pocopepe/visualizer/pll-sky130/docs/final_proposal/tab_dev.tex

\begin{tabular}{lrrrrrr}\toprule
Corner & N $I_d$ 0.9 V ($\mu$A) & P $I_d$ 0.9 V ($\mu$A) & N $I_d$ 1.8 V ($\mu$A) & P $I_d$ 1.8 V ($\mu$A) & N $V_{th}$ (V) & P $|V_{th}|$ (V) \\\midrule
ss & 27.9 & 0.112 & 401.2 & 69.9 & 0.6945 & 1.3376 \\
sf & 51.3 & 0.082 & 480.0 & 68.5 & 0.6333 & 1.3548 \\
tt & 36.9 & 0.211 & 438.2 & 86.5 & 0.6693 & 1.3229 \\
fs & 25.3 & 0.518 & 397.2 & 104.4 & 0.7054 & 1.2800 \\
ff & 47.7 & 0.403 & 475.4 & 103.2 & 0.6441 & 1.3000 \\
\bottomrule\end{tabular}
