pocopepe/visualizer/pll-sky130/docs/diagrams/vco_schematic.tex

\documentclass[border=10pt]{standalone}
\usepackage{circuitikz}
\begin{document}
\begin{circuitikz}[every node/.style={font=\small}]
% ===================== BIAS GENERATOR =====================
\node[font=\bfseries] at (0,9.3) {Bias generator};
\draw (0,7.6) node[vdd]{VDD};
\node[pmos, anchor=S] (Mpb) at (0,7.6) {};
\node[nmos, anchor=D] (Mnb) at (0,5.2) {};
\draw (Mpb.D) -- (Mnb.D);
\draw (Mnb.S) node[ground]{};
\draw (Mpb.G) -- ++(0,-0.6) coordinate(dg) -| (Mpb.D);
\coordinate (vbp) at (0,5.8);
\draw (vbp) node[circ]{};
\node[right] at (vbp) {\footnotesize vbiasp};
\draw (Mnb.G) -- ++(-0.6,0) node[left]{$V_{ctrl}$};
\node[left, xshift=-0.5cm] at (Mpb.west) {\footnotesize Mpb (diode)};
\node[right] at (Mnb.east) {\footnotesize Mnb};
% ===================== ONE RING STAGE =====================
\node[font=\bfseries, align=center] at (6,9.5) {One ring stage\\(current-starved inverter)};
\draw (6,7.6) node[vdd]{VDD};
\node[pmos, anchor=S] (Mpcs) at (6,7.6) {};
\node[pmos, anchor=S] (Mpinv) at (6,6.1) {};
\node[nmos, anchor=D] (Mninv) at (6,4.1) {};
\node[nmos, anchor=D] (Mncs) at (6,2.6) {};
\draw (Mpcs.D) -- (Mpinv.S) node[midway,circ]{} node[midway,right]{\footnotesize nodeA};
\draw (Mpinv.D) -- (Mninv.D) node[midway,circ](o){};
\draw (o) -- ++(0.9,0) node[right]{out};
\draw (Mninv.S) -- (Mncs.D) node[midway,circ]{} node[midway,right]{\footnotesize nodeB};
\draw (Mncs.S) node[ground]{};
\draw (Mpinv.G) -- ++(-0.4,0) coordinate(a) (Mninv.G) -- ++(-0.4,0) coordinate(b);
\draw (a) -- (b) node[midway,circ](in){};
\draw (in) -- ++(-0.6,0) node[left]{in};
\draw (Mpcs.G) -- ++(-2.2,0) node[left]{vbiasp};
\draw (Mncs.G) -- ++(-2.2,0) node[left]{$V_{ctrl}$};
\node[right] at (Mpcs.east) {\footnotesize Mp\_cs};
\node[right] at (Mpinv.east) {\footnotesize Mp\_inv};
\node[right] at (Mninv.east) {\footnotesize Mn\_inv};
\node[right] at (Mncs.east) {\footnotesize Mn\_cs};
\node[align=left, font=\footnotesize, text width=6cm] at (1.8,0.9) {gates of Mp\_cs/Mn\_cs are the SAME nets as the bias generator (vbiasp / $V_{ctrl}$)};
\end{circuitikz}
\end{document}
