pocopepe/visualizer/pll-sky130/docs/diagrams/method_flow.tex

\documentclass[tikz,border=10pt]{standalone}
\usetikzlibrary{arrows.meta,positioning}
\begin{document}
\begin{tikzpicture}[
  >=Stealth, thick, font=\sffamily\small, node distance=0.55cm and 0.55cm,
  st/.style={draw, rounded corners=3pt, minimum height=1.35cm, text width=2.55cm, align=center, fill=white},
  r1/.style={st, fill=gray!10},
  r2/.style={st, fill=blue!8, draw=blue!60!black},
  chk/.style={st, fill=green!8, draw=green!45!black},
  lab/.style={font=\sffamily\scriptsize, align=center}
]
\node[r1] (a) {Hand-written\\SPICE netlists\\(sky130, ngspice)};
\node[r1, right=of a] (b) {Each block\\verified\\standalone};
\node[r1, right=of b] (c) {Averaged loop\\model: 573 ns\\(sim: 577)};
\node[r1, right=of c] (d) {Closed loop\\locks: 577 ns\\(Review 1)};

\node[r2, below=1.2cm of a] (e) {11-corner grid\\(3$\times$3 + PDK skew)\\$\times$ 6 temperatures};
\node[r2, right=of e] (f) {Fit $f(T)$,\\derive $k_1,k_2$\\per corner};
\node[chk, right=of f] (g) {Held-out\\temperatures\\(never fitted)};
\node[chk, right=of g] (h) {Monte Carlo\\mismatch, n = 72\\paired by seed};

\node[r2, below=1.2cm of e] (i) {Cold-start boost;\\loop audit, R2\\retune ($\zeta$ 0.7)};
\node[chk, right=of i] (j) {Paired t-test +\\Wilcoxon on\\$|$drift$|$};
\node[r2, right=of j] (k) {Compare to\\$\pm0.3\%$ spec\\and literature};
\node[st, right=of k, fill=yellow!12] (l) {Review 3:\\transistor-level,\\layout, Spectre};

\draw[->] (a)--(b); \draw[->] (b)--(c); \draw[->] (c)--(d);
\draw[->] (d.south) -- ++(0,-0.35) -| (e.north);
\draw[->] (e)--(f); \draw[->] (f)--(g); \draw[->] (g)--(h);
\draw[->] (h.south) -- ++(0,-0.35) -| (i.north);
\draw[->] (i)--(j); \draw[->] (j)--(k); \draw[->] (k)--(l);

\node[lab, above=0.1cm of a, xshift=4.6cm] {\textbf{Review 1} --- build and close the loop};
\node[lab, above=0.1cm of e, xshift=4.6cm] {\textbf{Review 2} --- characterise, compensate, validate};
\node[lab, below=0.25cm of j, xshift=1.6cm, text width=12cm] {grey = Review 1\quad blue = design step\quad green = validation step (guards against fooling ourselves)};
\end{tikzpicture}
\end{document}
