pocopepe/visualizer/Final_Proposal_and_Findings.pdf

VIT Chennai – School of Electronics Engineering (SENSE)

## Design of a Temperature-Compensated PLL Frequency Synthesiser

Final Proposal and Findings Report

Aaryan Dogra Yugeshwaran | Viju Sanjai
23BEC1032 | 23BEC1404 | 23BEC1306
Guide: Dr. B. Bindu | Final review (Review-III): 28.10.2026
Document date: 28.10.2026

Abstract

A ring-oscillator VCO drifts strongly with temperature, which moves the control voltage, lock range, KVCO and lock time of a PLL built around it. We built a complete integer-N charge-pump PLL (226.2 MHz output, ÷8, 28.275 MHz reference) in the open SkyWater sky130B process and simulated it in ngspice. The VCO drift (uncompensated span 8.51 % at the typical corner) was characterised on 11 process corners, and an ideal behavioural first- and second-order correction was fitted and verified on all of them. It brings the nominal drift to within ±0.3 % at 8 of 11 corners (typical corner: 0.16 %); it misses at three slow-NMOS corners. Under transistor mismatch (Monte Carlo, n = 72) the compensated drift is limited to about 1.2–1.4 % by a mismatch floor, and the second-order term gives no statistically detectable benefit over the first. The closed loop locks to 8 × fref in every one of 28 simulated cases; the slowest case (ss, 85 ◦C, cold start, 2083 ns) misses the 2 µs specification by 4 %. Nine earlier errors, found and corrected during the work, are listed. Not yet done: the compensation network and charge pump are still behavioural, there is no layout, no jitter or phase-noise figure, and the cross-simulator (Cadence) test is blocked on tool access. Section 8 proposes a scoped plan with acceptance criteria and states what we need from the guide.

### 1 Introduction and problem

A phase-locked loop (PLL) frequency synthesiser multiplies a stable reference to a higher output frequency. Ring-oscillator VCOs are attractive for integrated PLLs because they are small and need no inductor, but their frequency changes strongly with temperature. In a PLL locked to an external reference the output is fout = N fref exactly, so the temperature coefficient of the locked output frequency is that of the reference and is not something the VCO design can change. The original project target of ±0.15 ppm stability therefore measures the reference crystal, not our circuit, and we propose to restate it (Section 8.3).
What temperature does degrade in a locked PLL is the following.
- Control voltage. The Vctrl needed for the target frequency moves with temperature and process. If it approaches a rail the loop loses lock range or lock.
- Lock range. Derived from the usable Vctrl window; the VCO is below 18 MHz for Vctrl < 0.65 V, so the practical floor is ≈ 0.65 V.
- KVCO. It sets loop bandwidth ωn ∝

√
KVCO and damping ζ ∝

√
KVCO at fixed filter, so
stability and settling move with process and temperature.
- Lock time. The time to acquire depends on the start state, KVCO and the distance to the lock voltage.

The aim of the project is therefore to reduce the free-running VCO drift with a compensation network and to show, in a complete closed loop, what that buys. The work is simulation-only in an open flow (Xschem/ngspice, Magic, netgen); it is staged as Review 1 (blocks and open-loop VCO), Review 2 (corners, compensation, Monte Carlo, first closed loop) and the present Final Review.

Contributions of this report. (i) A corner-aware characterisation of a current-starved ring VCO on 11 corners including a textbook 3 × 3 NMOS×PMOS set built from the PDK’s own model files; (ii) an ideal behavioural second-order compensation fitted on the measured f(T, V ) surface and verified at held-out temperatures; (iii) a paired Monte Carlo (n = 72) that identifies a mismatch floor; (iv) a 28-case closed-loop campaign; (v) an explicit list of nine corrections we made to our own earlier claims; (vi) a scoped plan for the remaining work.

### 2 Related work, novelty and research gap

Temperature-compensated ring oscillators and PLLs. Souliotis et al. report a fabricated PTAT-compensated ring-oscillator VCO in 180 nm CMOS with −1.5 %/+ 0.4 % frequency variation over −40 to 120 ◦C [1]; it is the closest published silicon and our main quantitative reference. Stancu et al. describe a temperature- and supply-compensated ring-oscillator clock circuit with 1.6 % temperature error in pre-layout simulation at 50 MHz [2]. Geng et al. present a fast-locking PLL synthesiser with temperature compensation (lock time below 2 µs, 9 mW) [3]. Further work on compensated or PVT-tolerant ring oscillators and ring VCOs is in [9, 10, 11, 13, 14, 15]; compensation of an LC-VCO inside a 12 GHz PLL is in [4]. General CMOS PLL synthesiser design references are [5, 8]. We read these as prior art for “a PTAT-type compensated ring VCO” and do not claim that idea.

Open-source analog flows. Freitas et al. compare open-source and commercial EDA for three blocks in IHP SG13G2, one of them a current-starved ring VCO, but their analog comparison is qualitative and open-loop [6]. Thiriloganathan et al. built a fully open-source 2.4 GHz fractional-N LC-VCO PLL in IHP SG13G2 and note the absence of PSS/Pnoise in open tools [7]. Open sky130 PLL projects exist as well (informal repositories, not cited as references).

Patent that narrows our novelty. US Patent 9,748,962 B2 (Infineon, 2017) combines a linear PTAT term with a squared term through a translinear squarer for oscillator temperature compensation over −40 to 85 ◦C [12]. The general idea “add a quadratic term to a linear compensator” is therefore not novel and we do not claim it. The patent is generic (it positions itself as an alternative to PLL-based stabilisation), not ring-VCO-specific, and none of the ring-oscillator papers above that we read goes beyond first order.

What is not novel. PTAT-compensated ring VCOs; quadratic compensation; PLLs built with open tools; open-vs-commercial EDA comparisons for digital blocks.

Gap and honest claim. What we did not find in the sources above is a closed-loop, per-corner, statistically validated study of curvature compensation of a ring VCO inside a PLL on an open PDK. That composite is our claim; each ingredient on its own is not. Our second planned claim, the cross-simulator hypothesis H1 (Section 8.7), is untested. This section is a literature check against the 15 references listed, not an exhaustive survey.

### 3 Design: architecture and block-level implementation

The loop is an integer-N charge-pump PLL (Fig. 1). Technology sky130B (volare commit c6d73a35); supply 1.8 V; simulator ngspice 47 (it reproduces the earlier ngspice-42 numbers exactly); all circuits are hand-written SPICE netlists run headless. Target output 226.2 MHz at Vctrl = 0.9 V (tt, 27 ◦C), fref = 28.275 MHz, N = 8.


Figure 1: PLL block diagram. PFD, divider and VCO are transistor-level; the charge pump is behavioural.

PFD. Edge detectors feeding a cross-coupled NOR SR latch (instead of resettable D flip-flops, to avoid fighting the latch feedback with an asynchronous reset). Functionally verified by sweeping the phase relationship.

Charge pump (behavioural). Icp = 20 µA, an ideal current source gated by UP/DN: no switch resistance, no mismatch, no charge injection. A 5× boost of the pump current is applied until the first divider edge, so that a true 0 V start can recover (Fig. 2).

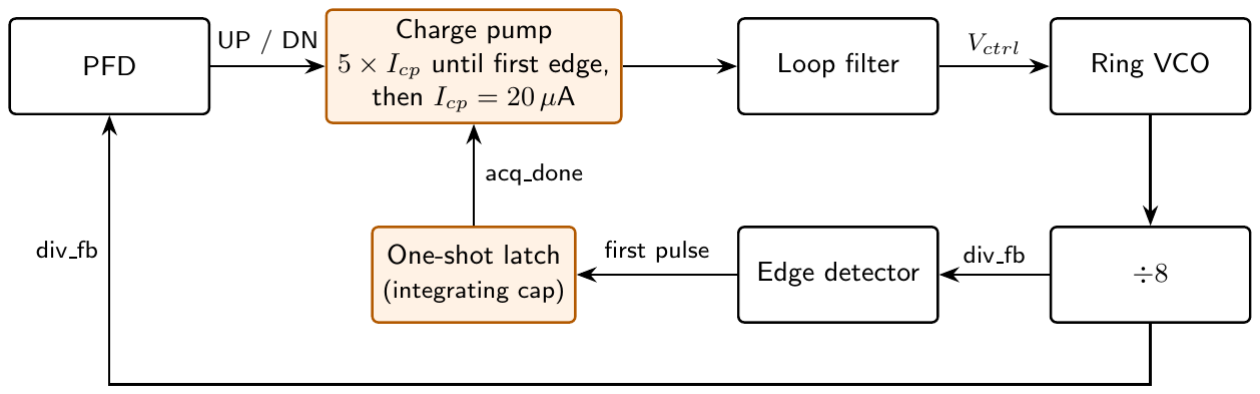
[picture p20: figure]

Figure 2: Acquisition aid: pump current boosted 5× until the first divider edge.

Loop filter. R2 = 3.6 kΩ in series with C1 = 68 pF, C2 = 6.8 pF in parallel. The original R2 = 1.7 kΩ is superseded (Section 6.3).

VCO. A 5-stage current-starved ring (Fig. 3). Vctrl drives the NMOS current-source gates directly and, through a V-to-I device and a PMOS mirror, the PMOS current sources, so it sets the delay per stage. Default sizing: switching devices W/L = 1.0/0.5 (N) and 2.0/0.5 (P), current sources 2.0/0.5 µm (all sky130 nfet_01v8/pfet_01v8); supply current about 58 µA at the 0.9 V bias point. The tuning curve is S-shaped: 18 MHz at 0.65 V to 358 MHz at 1.40 V (tt), 226.2 MHz at 0.9 V, with a local KVCO ≈ 890 MHz/V at 0.9 V (tt). There is no hard oscillation floor: 0.63, 2.1, 6.5 and 18 MHz at 0.50, 0.55, 0.60 and 0.65 V.

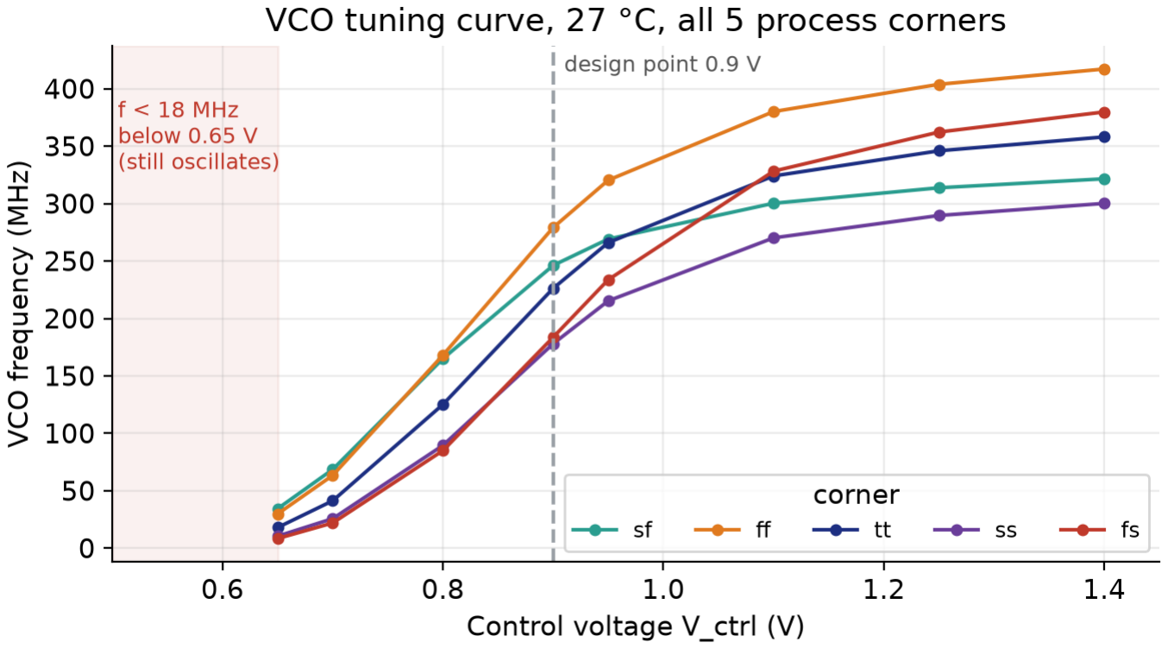
[picture p21: figure]

Figure 3: Left: current-starved ring VCO. Right: tuning curve at tt, 27 ◦C.

Divider. ÷8 from three cascaded toggle flip-flops; measured ratio 8.004 in the block test.

Compensation network (behavioural). In the simulations the correction is an ideal voltage source in series with Vctrl:

V

eff
ctrl = Vctrl + k1(T − 27) + k2(T − 27)²
. | (1)

k2 = 0 gives a first-order (PTAT/CTAT-equivalent) network. A transistor-level realisation (PTAT/CTAT plus translinear squarer) is proposed in Section 8 (Fig. 4).

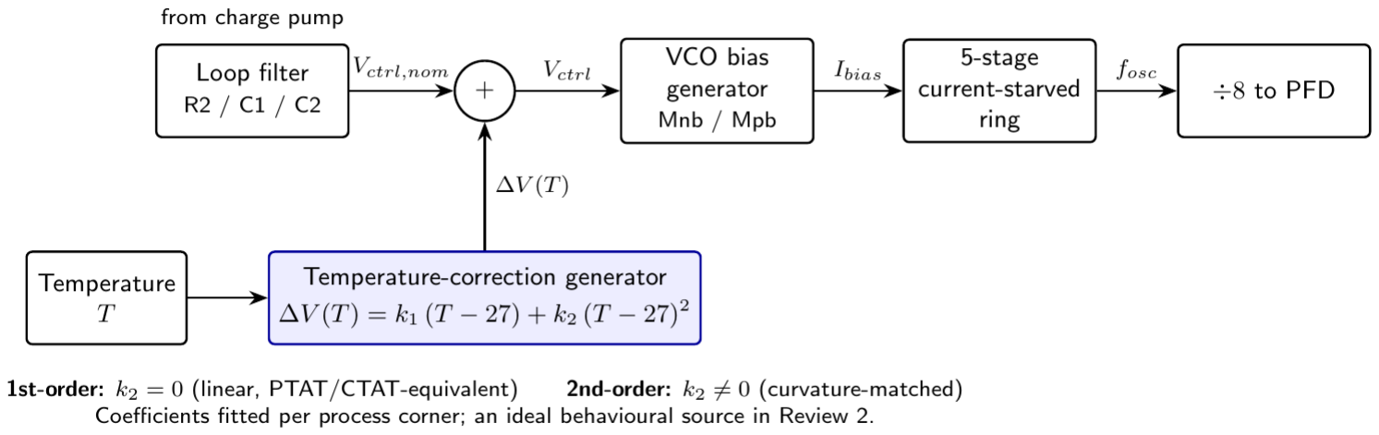
[picture p22: figure]

Figure 4: Compensation architecture (target realisation; the present simulations use the ideal source of Eq. 1).

### 4 Methodology

### 4.1 Simulation flow

Every result is produced by headless ngspice batch runs driven by Python scripts, from netlists under blocks/. Raw outputs and per-run JSON are kept under results/; every headline number is regenerated into results/final_numbers.md by a script, and the tables in this report are generated from that file. Appendix A lists the commands.

### 4.2 Corner methodology

sky130 ships the corners ss, tt, ff and two skew corners sf, fs. During the final preparation we found that the VCO results did not look like textbook corners and audited them. We measured the devices directly (Table 1) and found: (a) in this PDK sf is fast-NMOS/slow-PMOS and fs is slow-NMOS/fast-PMOS (measured; our earlier labels were reversed; the PDK documentation does not state it unambiguously); (b) the skew corners shift each device further than ss/ff do: extracted NMOS Vth vs tt is +25 (ss), −25 (ff), −36 (sf), +36 mV (fs), PMOS |Vth| +15, −23, +32, −43 mV. At the VCO bias (overdrive ≈ 0.2 V) this becomes ≈ 9 % in drive current, so the PDK skews lie outside the ss–ff envelope at 0.9 V but inside it at 1.8 V (NMOS Id within 1 %).

Corner | N Id 0.9 V (µA) | P Id 0.9 V (µA) | N Id 1.8 V (µA) | P Id 1.8 V (µA) | N Vth (V) | P |Vth| (V)
ss | 27.9 | 0.112 | 401.2 | 69.9 | 0.6945 | 1.3376
sf | 51.3 | 0.082 | 480.0 | 68.5 | 0.6333 | 1.3548
tt | 36.9 | 0.211 | 438.2 | 86.5 | 0.6693 | 1.3229
fs | 25.3 | 0.518 | 397.2 | 104.4 | 0.7054 | 1.2800
ff | 47.7 | 0.403 | 475.4 | 103.2 | 0.6441 | 1.3000

Table 1: Single-device audit at 27 ◦C (W/L = 2/0.5 µm, ngspice 47). Skew corners fall outside the ss–ff band for the NMOS at 0.9 V (25.3 and 51.3 vs 27.9 and 47.7 µA). PMOS at 0.9 V is sub-threshold.

We therefore report on 11 corners: a textbook 3 × 3 set (NMOS slow/typ/fast × PMOS slow/typ/fast), named nXpY (nsps=ss, ntpt=tt, nfpf=ff exactly as in the PDK), built by swapping the NMOS and PMOS model files independently (scripts/make_factorial_lib.py; the diagonal reproduces the PDK ss/tt/ff to the digit: 177.993/226.206/279.178 MHz), plus the PDK’s own skews as wider “foundry” extremes. We always label by device behaviour, never by the letters alone.

### 4.3 Compensation fit

The first analytic coefficients (Review 2) were derived from a wrong KVCO and a first-order guess; they are superseded (Section 6.3). The method now used (scripts/comp_factorial.py), per corner:
1. measure f(T, V ) at V ∈ {0.85, 0.90, 0.95} V and T ∈ {−40, −20, 0, 27, 50, 85}

◦C (no correction);
2. solve for the exact shift ∆V
| | ∗
(T) that restores f(27 ◦C) (quadratic interpolation in V );
3. least-squares fit ∆V

∗ = k1∆T (first order) and k1∆T + k2∆T
| | | | 2
(second order), ∆T = T − 27;
4. verify by simulating the compensated VCO at the six fit temperatures and at four held-out temperatures (−30, 10, 40, 70 ◦C).

Reported metrics: span = (fmax − fmin)/f27 and maximum deviation from f27 (the quantity that the ±0.3 % specification refers to), both at Vctrl = 0.9 V. The compensation ratio is C = baseline span / second-order span.

### 4.4 Monte Carlo and paired statistics

Device mismatch is enabled through the PDK’s mismatch switch with a fixed random seed set first in each run. Each seed is one simulated chip, run through all three arms (uncompensated, first order, second order) at −40 and 85 ◦C with the tt coefficients; the drift is |f(85) − f(−40)|. Arms are paired by seed; we use a paired t test with a 95 % CI and a Wilcoxon signed-rank test, and the metric is |drift| because over- and under-correction are equally bad (our first analysis tested the signed drift and was wrong; Section 6.3). n = 72 chips. Statistics are hand-written (scripts/stats.py) and self-checked.

### 4.5 Closed-loop campaign

scripts/closed_loop_campaign.py runs the full transistor-level loop (behavioural charge pump) at all 11 corners from two start states: a coarse start (Vctrl = 0.85 V) and a true cold start (Vctrl = 0 V, boosted pump); plus cold starts at −40 and 85 ◦C for ss, tt, ff. Each run is 5 µs. Lock time is the time after which Vctrl stays within ±2 % of its final value (specification < 2 µs). In total 28 simulations.

### 5 Results

### 5.1 Corner audit and VCO characterisation

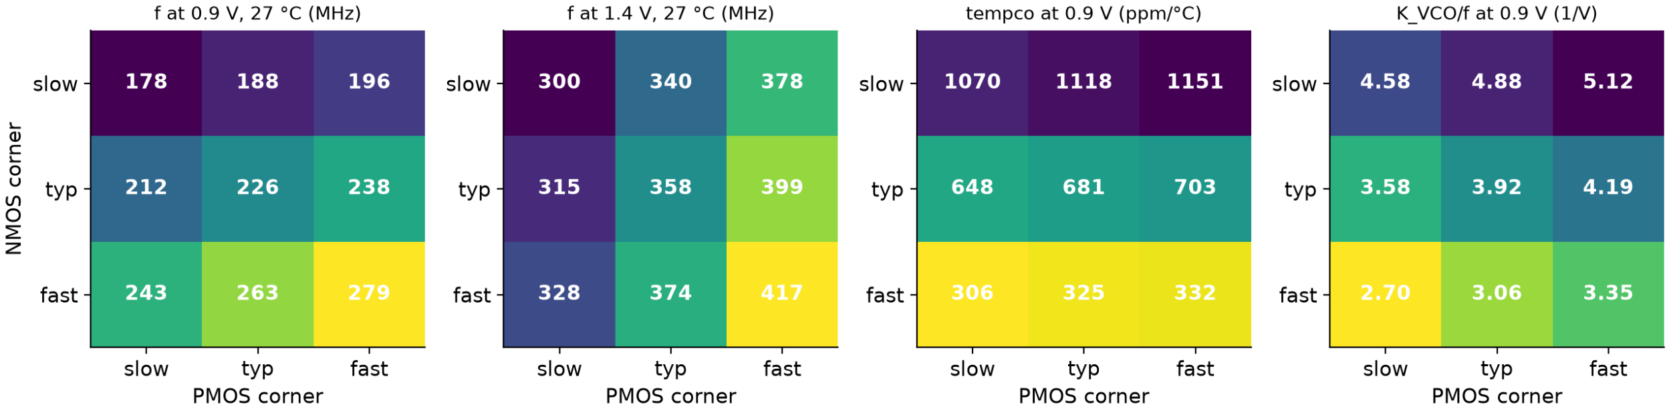
[picture p23: figure]

Figure 5: Textbook 3 × 3 NMOS×PMOS set. From left: f at 0.9 V, f at 1.4 V (27 ◦C), tempco at 0.9 V (ppm/ ◦C), KVCO/f (1/V).

At 0.9 V and 27 ◦C the frequency is 178.0/188.0/195.9 (N slow), 211.8/226.2/238.1 (N typ), 242.8/262.7/279.2 MHz (N fast) for P slow/typ/fast. Tempco is 1070/1118/1151, 648/681/703 and 306/325/332 ppm/ ◦C; the textbook range is 306–1151 (3.8×) and the PDK five-corner range is 112 (sf)–1399 (fs) ppm/ ◦C (12.5×), with ss 1070, tt 681 and ff 332. All 8 monotonicity checks pass (frequency rises with NMOS and with PMOS strength at 0.9 and 1.4 V; tempco falls with NMOS strength). The only failed expectation is that the PDK skews’ tempco lies inside [ff, ss]; it does not, even in a clean textbook set tempco is not bounded by ff and ss. Physics checks pass: Vth tempco −0.78 mV/ ◦C (N) and −1.1 mV/ ◦C (P); NMOS Id at 1.8 V falls with temperature (−30 %) while at 0.9 V it rises (+14 %), i.e. the bias sits below the zero-tempco point; at Vctrl = 1.4 V the tempco is −816 ppm/ ◦C (sign flip). At 0.9 V the NMOS limits the ring (36 % spread slow-to-fast N vs 10 % across P); at 1.4 V the PMOS does (26 % vs 9 %). Uncompensated at tt the span is 8.51 %. Local KVCO at 0.9 V (MHz/V): sf 580, ff 940, tt 890, ss 820, fs 1020 (the earlier 669 was wrong).


Figure 6: Left: uncompensated VCO drift vs temperature (tt). Right: tempco ranks with NMOS drive.

### 5.2 Compensation on 11 corners

Corner | f0 (MHz) Base span (%) 2nd span (%) Max dev (%) Held-out (%) | C ±0.3 %
nsps (ss) | 178.0 | 13.37 | 0.35 | 0.277 | 0.175 38.4 yes
nspt | 188.0 | 13.97 | 0.38 | 0.301 | 0.201 37.2 NO
nspf | 195.9 | 14.38 | 0.42 | 0.325 | 0.223 34.3 NO
ntps | 211.8 | 8.10 | 0.24 | 0.195 | 0.109 33.6 yes
ntpt (tt) | 226.2 | 8.51 | 0.20 | 0.162 | 0.091 43.2 yes
ntpf | 238.1 | 8.79 | 0.20 | 0.168 | 0.097 43.7 yes
nfps | 242.8 | 3.82 | 0.12 | 0.079 | 0.034 31.0 yes
nfpt | 262.7 | 4.06 | 0.12 | 0.102 | 0.041 33.3 yes
nfpf (ff) | 279.2 | 4.15 | 0.11 | 0.093 | 0.035 37.0 yes
PDK sf (N fast, P slow) | 246.2 | 1.49 | 0.09 | 0.051 | 0.036 15.9 yes
PDK fs (N slow, P fast) | 183.7 | 17.49 | 0.49 | 0.360 | 0.251 35.8 NO

Table 2: Compensation, nominal (no mismatch), ideal behavioural source, Vctrl = 0.9 V. “Max dev” is the maximum deviation from f27 of the second-order-compensated VCO at the 6 fit temperatures; “Held-out” the same at −30, 10, 40, 70 ◦C.

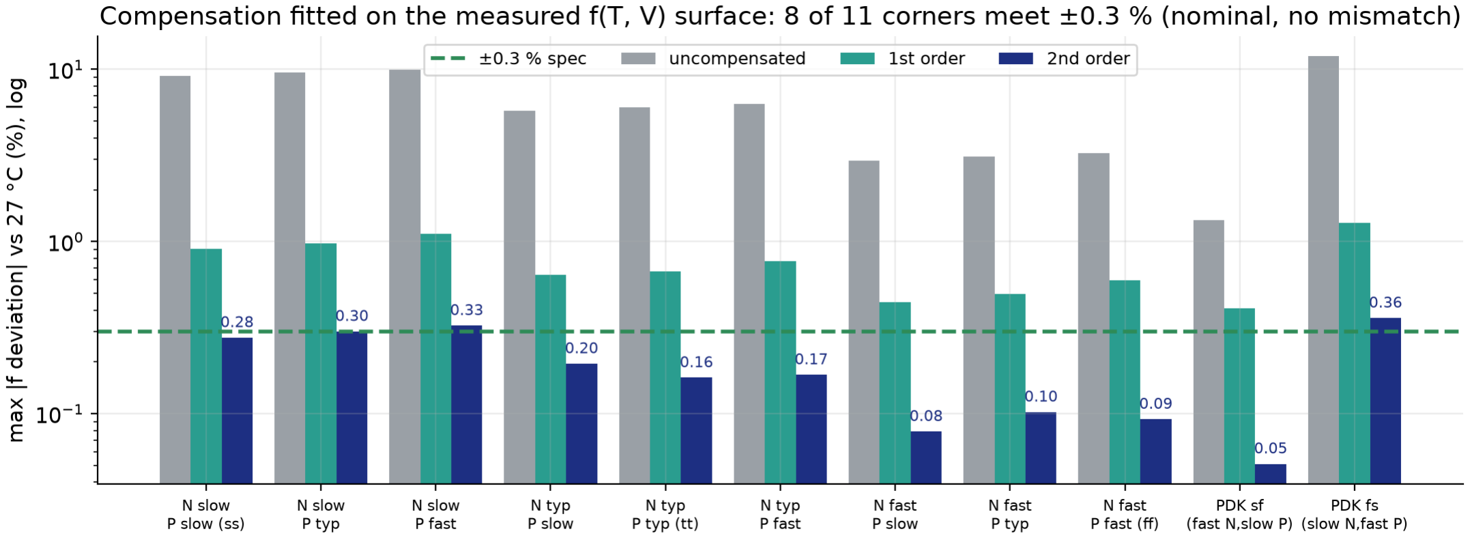
[picture p24: figure]

Figure 7: Maximum deviation from f27 (log scale) for the uncompensated, first-order and second-order cases at 11 corners.

At tt the span falls from 8.51 % to 0.67 % (first order) and 0.20 % (second order), maximum deviation 0.16 % (specification ±0.3 % met), held-out 0.09 %, with k1 = −1.543 × 10⁻⁴ V/ ◦C and k2 = 4.18 × 10⁻⁷ V/ ◦C
2
. 8 of 11 corners meet ±0.3 % (7 of the 9 textbook corners). The misses are nspt 0.301 % (borderline), nspf 0.325 % and PDK fs 0.360 %; all are slow-NMOS corners, the hardest. C lies between 31 and 44 for ten corners and is 15.9 for PDK sf (small baseline drift). Held-out maxima are 0.03–0.25 %, so the two fitted coefficients do not over-fit the five non-reference fit temperatures. Per-corner coefficients are in Appendix B.

Caveats on this result
The correction is an ideal source (no transistor-level network, no noise, no supply dependence); it is nominal (no mismatch); two coefficients are fitted to five temperature points; and the fit is made at Vctrl = 0.9 V while each corner locks at its own Vctrl (Section 5.4).

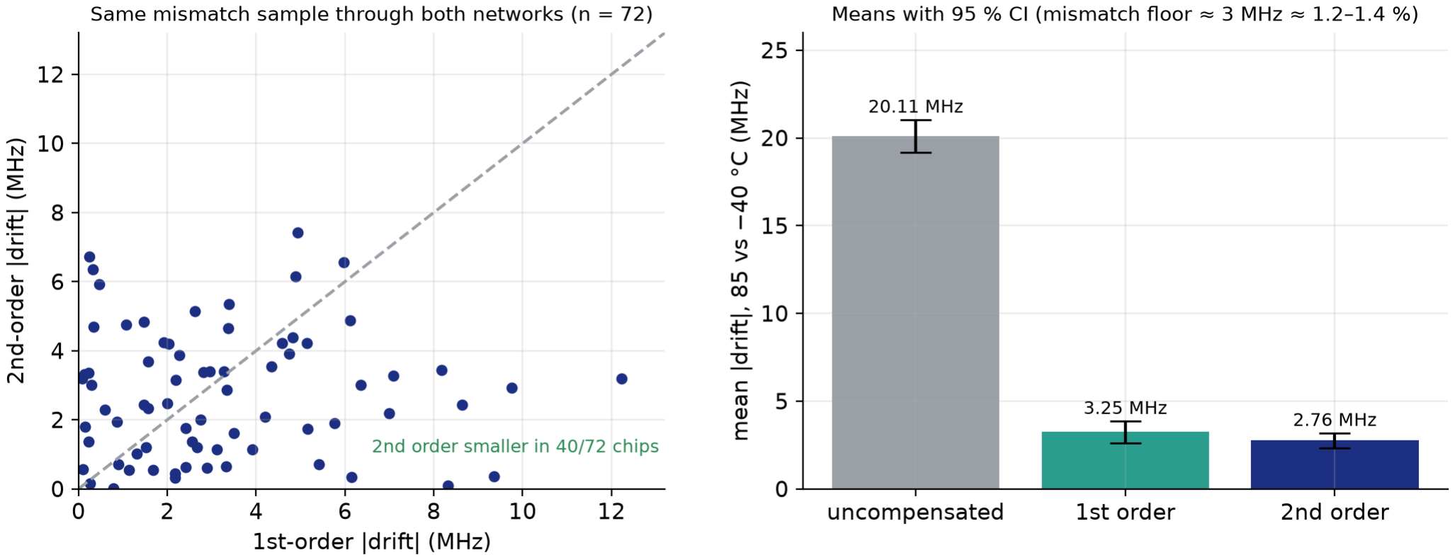
[picture p25: figure]

Figure 8: Monte Carlo at tt with mismatch (n = 72 chips, paired by seed). Left: second- vs first-order |drift| per chip. Right: means with 95 % CI.

Arm | mean |drift| (MHz) | 95 % CI (MHz) | as % of 226.2 MHz
Uncompensated | 20.11 | [19.18, 21.04] | –
First order | 3.25 | [2.63, 3.87] | 1.4
Second order | 2.76 | [2.33, 3.19] | 1.2
Paired comparison | reduction (MHz), CI | wins
Base → 1st | 16.86 [15.57, 18.16] | 71/72
Base → 2nd | 17.35 [16.37, 18.34] | 72/72
1st → 2nd | 0.49 [−0.26, 1.24], n.s. | 40/72

Table 3: Monte Carlo statistics. Both t and Wilcoxon tests agree: both compensations significantly reduce drift; 1st → 2nd is not significant.

### 5.3 Monte Carlo, n = 72, and the mismatch floor

Either compensation removes 84–86 % of the drift under mismatch, in nearly every chip. But the residual of about 3 MHz (1.2–1.4 % of 226 MHz) is several times the nominal residual (0.2–0.7 %): it is a mismatch floor. Chip-to-chip mismatch makes every chip’s own drift differ (signed drift std 4.1 MHz first order, 3.3 MHz second order), and one global correction cannot remove a per-chip error. With correctly fitted coefficients the second-order term gives no statistically detectable benefit under mismatch. Reaching ±0.3 % across chips would require per-chip trim (Section 8.4). Monte Carlo was run at the tt corner only.

### 5.4 Closed loop

Retune. The Review-1 filter design had dropped the 1/(2π) of the PFD/charge-pump gain, so ζ was 0.33, not 0.72. Retuning R2 from 1.7 to 3.6 kΩ gives ζ ≈ 0.70 (phase margin ≈65–70◦ by the 100ζ rule, not a Bode plot). At tt: coarse-start lock 577 →503 ns, cold start 839 → 1351 ns (slower but within specification), ripple 8.6 → 0.35 mV, final frequency error 0.78 % → 0.008 %. The original loop had not settled within 2 µs at ff, sf, fs, ss. Only R2 = 1.7, 3.0 and 3.6 kΩ were simulated at transistor level; 3.6 kΩ is not claimed optimal.

Lock at all corners. In all 28 runs fVCO = 226.17 MHz (−0.01 %, the bias of the crossing detector) = 8fref , ripple ≤ 0.8 mV, all settled. Lock times at 27 ◦C are in Table 4 and Fig. 9; all are below 2 µs.

Corner | Vlock (V) | Coarse start (ns) | Cold start (ns)
nsps (ss) | 0.968 | 967 | 1675
nspt | 0.944 | 645 | 1531
nspf | 0.930 | 573 | 1354
ntps | 0.920 | 678 | 1537
ntpt (tt) | 0.900 | 503 | 1351
ntpf | 0.888 | 177 | 1318
nfps | 0.877 | 387 | 1391
nfpt | 0.860 | 279 | 1316
nfpf (ff) | 0.849 | 241 | 1282
PDK sf (N fast, P slow) | 0.869 | 419 | 1388
PDK fs (N slow, P fast) | 0.942 | 576 | 1355
Corner | −40 ◦C | 27 ◦C | 85 ◦C
ss | 1633 | 1675 | 2083
tt | 1318 | 1351 | 1418
ff | 1248 | 1282 | 1317

Table 4: Top: lock voltage and lock time at 27 ◦C by corner. Bottom: cold-start lock time (ns) vs temperature. The ss/85 ◦C case misses the 2 µs specification by 4 % (2083 ns).

Validation checks. (i) The closed-loop lock Vctrl equals the open-loop Vctrl for 226.2 MHz within 0.2 mV at all 11 corners (Fig. 11). (ii) At tt the lock voltage moves +11.9 mV at −40 ◦C and −7.5 mV at 85 ◦C, matching the fitted compensation correction at tt (+12.2/−7.5 mV): an independent confirmation of the compensation fit at tt. At other corners the comparison is not valid because the compensation is fitted at 0.9 V whereas each corner locks at its own Vctrl (ss 0.968, nspt 0.944, nspf 0.930, ntps 0.920, tt 0.900, ntpf 0.888, nfps 0.877, nfpt 0.860, ff 0.849, PDK sf 0.869, PDK fs 0.942 V). This motivates defining the compensation target at each corner’s own lock voltage

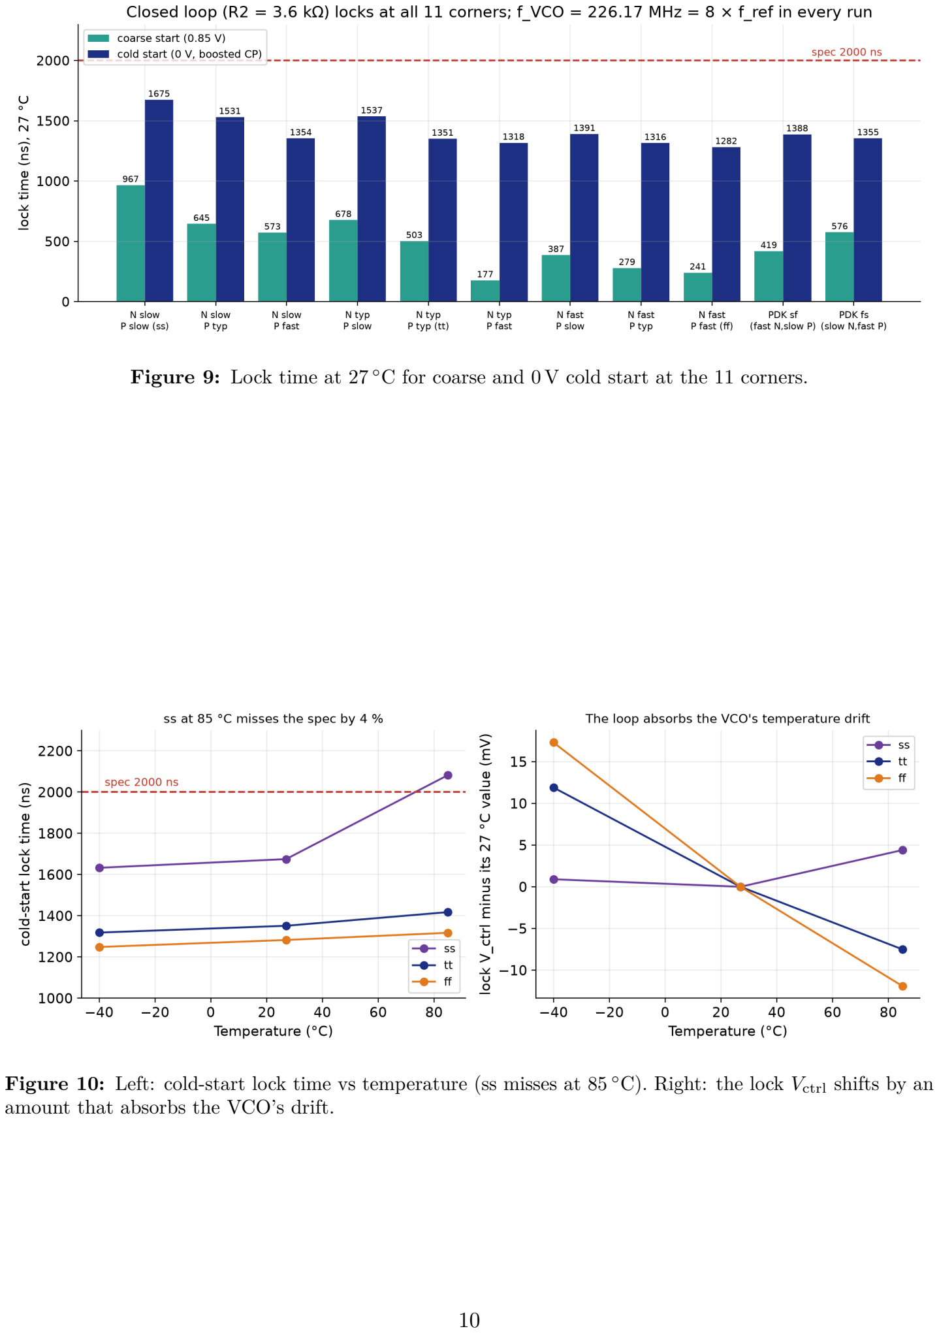
[picture p26: page 10]

Figure 9: Lock time at 27 ◦C for coarse and 0 V cold start at the 11 corners.

Figure 10: Left: cold-start lock time vs temperature (ss misses at 85 ◦C). Right: the lock Vctrl shifts by an amount that absorbs the VCO’s drift.

(Section 8.5). (iii) An earlier averaged behavioural model of the loop reproduced the original 577 ns lock to within 1 % (573 ns).


Figure 11: Left: closed-loop vs open-loop lock Vctrl at 11 corners. Right: 0 V cold start at ss, tt, ff.

### 6 Discussion

### 6.1 What the numbers mean

The locked output frequency does not drift; what the PLL does is move Vctrl to absorb the VCO’s drift, and compensation reduces how far Vctrl has to move. Process, not temperature, dominates the lock voltage: across corners Vctrl at lock spans 0.849–0.968 V (119 mV), while temperature moves it by about 20 mV at tt. All lock voltages stay well above the 0.63 V practical floor, so lock range was not the limit in any simulated case. The loop closes in every case, and its dynamics move with process because KVCO varies from 580 to 1020 MHz/V. The weak spot is a slow-NMOS, hot cold start (ss, 85 ◦C).

### 6.2 Comparison with the literature (honest)

The only cleanly comparable metric is residual frequency variation over temperature. Souliotis et al. measured −1.5 %/ + 0.4 % (about 1.9 % total) over a wider range, −40 to 120 ◦C [1]; Stancu et al. report 1.6 % in simulation [2]. Our uncompensated tt span of 8.51 % is worse than both, as expected. Our compensated nominal span (0.20 % at tt) is far below them, but this is a simulation of an ideal network, with no mismatch, noise or supply dependence, against measured silicon [1]: it must not be read as beating published silicon. The number that is comparable in spirit is the mismatch-limited 1.2–1.4 %, which is in the range of [1, 2], still from simulation of an ideal network. Lock time (< 2 µs; 503 ns coarse, 1351 ns cold at tt) meets the figure quoted by [3], which is measured silicon at a much higher output frequency. We have no phase-noise number for comparison. The benchmark table is in docs/benchmark_table.md (it needs updating to the final numbers).

### 6.3 Corrections we made, and what they teach

1. sf/fs labels were reversed. Lesson: measure what a model name means; do not assume it.
2. Tempco mechanism rewritten: it follows NMOS overdrive, not N/P current-source balance.

3. KVCO 669 → ≈ 890 MHz/V. The 669 came from a fit over the whole S-shaped curve; the local slope at the operating point is what matters.
4. No hard 0.63 V oscillation floor. It was an artefact of a short simulation window.
5. Loop design dropped 1/(2π): ζ was 0.33 not 0.72; retuned to 0.70. Independent re-derivation caught it.
6. Compensation coefficients were mis-estimated through the wrong KVCO and a first-order guess; the new fit meets the specification at tt (0.16 %) and 8 of 11 corners. The Review-2 tt values (1.12 % span, 0.87 % max deviation, specification missed) are superseded.
7. Monte Carlo repeated with correct coefficients: the Review-2 claim “second order significantly better than first (23/30 seeds)” compared against a mis-tuned first-order arm and is withdrawn; at n = 72 it is not significant. (An earlier error, testing signed instead of absolute drift, had also been corrected.)
8. PDK skew corners are wider than ss/ff, not inside the envelope; the textbook 3 × 3 set was added.
9. The closed-loop campaign found that ss/85 ◦C cold start misses 2 µs by 4 %. Lesson: test the worst corner and temperature together, not separately.
Common thread: derived quantities (analytic coefficients, damping, expected corner order) were wrong more often than simulated ones, and each was caught by an independent numerical check. The plan in Section 8 keeps that practice.

### 6.4 Threats to validity

- Ideal blocks. Compensation and charge pump are behavioural; transistor-level versions may change every number in Sections 5.2–5.4.
- Single simulator, single model set. ngspice with the legacy per-corner PDK models. The PDK also ships “continuous” parameter files with different skew deltas (NMOS Vth ±15 mV for ss/ff vs ±27 mV for sf/fs); the qualitative story is the same, but the numbers would differ. This is exactly what the planned Spectre arm tests.
- Nominal fit, Monte Carlo at one corner. Mismatch was not run at other corners; the fit is at Vctrl = 0.9 V only.
- Few temperature points. Two coefficients fitted to five points, mitigated by the held-out check.
- Lock metric. The ±2 % band is sensitive at its edge (the 503 ns tt result is set by a small overshoot just outside the band); damping uses the 100ζ rule, not a Bode plot.
- Temperature coverage of closed loop. Cold start at ± temperature was simulated at three corners only; not all 11 corners at all temperatures.
- Corner definitions. SkyWater’s published documentation of the corner columns is internally inconsistent; we rely on our own measurements.

### 7 Research findings summary

1. Locked output frequency is 8fref to within −0.01 % in all 28 simulated cases; temperature acts through Vctrl, KVCO and lock time, not the output frequency.
2. The uncompensated VCO tempco spans 12.5× across the PDK corners (112–1399 ppm/ ◦C) and 3.8× in a textbook 3 × 3 set (306–1151 ppm/ ◦C); tt span is 8.51 %.
3. sky130’s skew corners are wider than ss/ff (NMOS Vth ±36 vs ±25 mV) and fall outside the ss–ff envelope by 8–9 % in drive at the 0.9 V bias, but within 1 % at 1.8 V.
4. Tempco ranks with NMOS drive at 0.9 V (NMOS overdrive dominates) and the limiting device flips to the PMOS at 1.4 V; at Vctrl = 1.4 V the tempco changes sign (−816 ppm/ ◦C).
5. An ideal second-order correction fitted on measured f(T, V ) reduces the nominal tt span from 8.51 % to 0.20 % (max deviation 0.16 %, held-out 0.09 %).

6. The ±0.3 % specification is met nominally at 8 of 11 corners and missed at nspt (0.301 %), nspf (0.325 %) and PDK fs (0.360 %).
7. Compensation ratios are 31–44 at ten corners (15.9 at PDK sf).
8. Under mismatch (n = 72, tt), mean |drift| falls from 20.11 MHz to 3.25 MHz (first order) and 2.76 MHz (second order), in 71/72 and 72/72 chips.
9. The residual is a mismatch floor of about 1.2–1.4 % (about 3 MHz), several times the nominal residual (0.2–0.7 %), and the second order is not significantly better than the first (0.49 MHz, CI [−0.26, 1.24], 40/72 chips).
10. The retuned loop (R2 = 3.6 kΩ, ζ ≈ 0.70) locks to 8fref at all 11 corners from a coarse start (177–967 ns) and a 0 V cold start (1282–1675 ns) at 27 ◦C.
11. The worst case, ss at 85 ◦C cold start, takes 2083 ns and misses the 2 µs specification by 4 %.
12. Closed-loop lock Vctrl equals the open-loop value within 0.2 mV at 11 corners; at tt its temperature shift (+11.9/−7.5 mV) equals the fitted correction (+12.2/−7.5 mV).
13. Corners lock between 0.849 and 0.968 V while compensation is fitted at 0.9 V, so the compensation target should be defined at each corner’s own lock voltage.

### 8 Proposal for the remaining work

All items are proposed; targets are for discussion with the guide. Everything stays in the existing flow, so each item re-uses the scripts of Appendix A.

### 8.1 Transistor-level compensation network (PTAT/CTAT plus squarer)

Deliverable: netlist of a PTAT/CTAT current generator and a translinear squarer driving V

eff
ctrl,
replacing Eq. 1, with k1, k2 set by device ratios and bias. Acceptance: nominal tt maximum deviation ≤ 0.3 % over −40 to 85 ◦C with the network in the loop, held-out points included; agreement with the ideal-source result of Table 2 reported; re-run at the 11 corners and the misses of Table 2 stated, not hidden. Novelty guard: the patent [12] is cited and our claim stays the composite of Section 2.

### 8.2 Transistor-level charge pump

Deliverable: switch-level pump with UP/DN current matching, keeping the 5× acquisition boost. Acceptance: lock at tt, ss and ff from 0 V in < 2 µs, final frequency error < 0.1 %, ripple reported; the loop campaign of Section 4.5 re-run with the new pump and the ss/85 ◦C case re-checked (it may need a larger boost or a changed R2).

### 8.3 Specification restatement (sign-off request)

Replace ±0.15 ppm (a reference property in a locked PLL) with: residual VCO free-running drift ≤ ±0.3 % (≈ ±24 ppm/ ◦C) over −40 to 85 ◦C and, as loop-level metrics, Vctrl within [0.35VDD, 0.85VDD] ≈ [0.63, 1.53] V (revised from an original floor of 0.15VDD because the ring is below 18 MHz under 0.65 V), lock time < 2 µs, KVCO variation tracked. We ask the guide to confirm both revisions.

### 8.4 Per-chip trim to beat the mismatch floor

Deliverable: a trim scheme (for example a few-bit trim of k1 and the squarer gain, set from a one-point or two-point temperature measurement) evaluated by Monte Carlo. Acceptance: on ≥ 72 paired chips, |f(85) − f(−40)| ≤ 1.36 MHz (0.6 %, i.e. ±0.3 % endpoints) for the large majority of chips (target 90 %), against 2.76 MHz untrimmed; the trim range, resolution and the test cost it implies are stated.

### 8.5 Compensation at each corner’s lock voltage

Deliverable: refit k1, k2 at each corner’s own lock Vctrl (0.849–0.968 V, Section 5.4) with the same verification method. Acceptance: nominal maximum deviation reported at all 11 corners at their own Vctrl; the three current misses re-assessed; the closed-loop lock-voltage shift of Fig. 10 compared against the fitted correction at every corner, not only tt.

### 8.6 Layout, DRC, LVS and post-layout

Deliverable: Magic layout of the VCO, divider, PFD and compensation block; DRC clean; LVS with netgen (built at ~/tools/netgen/bin/netgen, verified on a test pair with the sky130B setup file) reporting “circuits match uniquely”; parasitic extraction and post-layout re-simulation. Acceptance: DRC 0 violations, LVS match, post-layout frequency shift and lock time reported against the pre-layout values; any loss of the ±0.3 % or 2 µs margin stated.

### 8.7 Cadence Spectre/Virtuoso arm, PSS/Pnoise, and the H1 test

Deliverable: the identical testbenches in Spectre on the same PDK, PSS/Pnoise jitter and phase noise of the VCO and loop (the target < −80 dBc/Hz at 10 kHz is currently only an estimate-type target), and the regression for hypothesis H1: εres ≈ C εraw, where C is the compensation ratio and εraw the ngspice–Spectre disagreement on raw quantities. Acceptance: ≥ 6–10 distinct C values (from a compensation-strength sweep), a pre-registered null (β = 0 vs β = 1), slope with 95 % CI. Note that the present alpha sweep is nearly circular and is not the H1 test. This item is blocked on department Virtuoso/Spectre access. Without it the project still delivers items 8.1–8.6, and H1 would be reported as untested.

### 8.8 Paper and artifact

A manuscript (corner methodology, mismatch floor, closed-loop study, corrections) and a repro-ducible artifact (netlists, scripts, results, one-command rebuild of final_numbers.md); related-work section citing [12, 1, 6, 7].

### 8.9 What we need from the guide

1. Virtuoso/Spectre access (licence, lab slot, and a sky130 PDK for Cadence, or permission to port the model files) for Section 8.7.
2. Specification sign-offs: the Vctrl floor revision to [0.63, 1.53] V and the restatement of ±0.15 ppm (Section 8.3).
3. Scope priority among 8.1, 8.2, 8.4 and 8.5 if time is short, and agreement that an ideal-network-plus-transistor-level-validation result is acceptable if trim is not finished.
4. Acceptance criteria: confirmation or changes to the targets above.

### 8.10 Milestones

Dates are proposed; after Review-III the plan is re-baselined with the guide’s input.

Date | Milestone
20.10.2026 | This report and final-review slides sent to the guide.
21–22.10 | Guide feedback; Virtuoso access request; sign-offs of 8.3.
22–25.10 | First transistor-level charge pump in the loop (tt, ss, ff); compensation-at-lock-voltage refit at tt (8.5).
26–27.10 | Slides and report frozen; rehearsal; numbers re-checked against final_numbers.md.

28.10.2026 Review-III.

Nov 2026 | Transistor-level PTAT/CTAT plus squarer (8.1); full 11-corner loop re-run with both transistor-level blocks (8.2).
Dec 2026 | Per-corner lock-voltage compensation (8.5); per-chip trim study and Monte Carlo (8.4).
Jan 2027 | Layout, DRC, LVS, extraction, post-layout simulation (8.6).
Feb 2027 | Spectre arm, PSS/Pnoise and H1 regression, if access is
| granted by Nov 2026.
Mar 2027 | Manuscript and artifact release (8.8); final report.

Table 5: Milestones. Rows after Review-III are indicative.

### 9 Limitations

Stated plainly: (1) compensation and charge pump are behavioural; (2) no layout, DRC, LVS or post-layout result; (3) no jitter or phase-noise number (no PSS/Pnoise in the open tools); (4) phase margin is the 100ζ rule, not a Bode plot; (5) only R2 = 1.7/3.0/3.6 kΩ simulated at transistor level and 3.6 kΩ is not claimed optimal; (6) cold start simulated at all corners at 27 ◦C and at three corners for ± temperature only; (7) the compensation fit is nominal and at Vctrl = 0.9 V;
(8) mismatch limits the compensated drift to about 1.2–1.4 % (tt only); (9) three corners (nspt, nspf, PDK fs) miss the ±0.3 % target nominally; (10) ss/85 ◦C cold start (2083 ns) exceeds 2 µs;
(11) H1 and the Spectre arm are untested; (12) single simulator, single model set, no silicon.

### References

[1] G. Souliotis, E. Keramida, F. Plessas, R. Malatesta, and S. Vlassis, “Temperature compensated ring oscillator based VCO,” AEU – Int. J. Electron. Commun., vol. 149, Art. no. 154195, May 2022.
[2] C. Stancu, A. Neacsu, O. Profirescu, D. Dobrescu, and L. Dobrescu, “Temperature and power supply compensated CMOS clock circuit based on ring oscillator,” Electronics, vol. 12, no. 3, Art. no. 507, Jan. 2023.
[3] Z. Geng, X. Ma, and Z. Li, “A low power fast locking PLL frequency synthesizer with temperature compensation,” in Proc. 3rd Int. Conf. EAME, Atlantis Press, Jun. 2018, pp. 281–285.
[4] Y. You, D. Huang, J. Chen, and S. Chakraborty, “A 12GHz 67% tuning range 0.37ps RJrms PLL with LC-VCO temperature compensation scheme in 0.13 µm CMOS,” in Proc. IEEE RFIC, Tampa, FL, USA, Jun. 2014, pp. 101–104.
[5] S. Sinha, “Design of an integrated CMOS PLL frequency synthesizer,” in Proc. 11th IEEE MELECON, Cairo, Egypt, 2002, pp. 220–224.

[6] É. M. V. Freitas et al., “Using open source EDA tools in ASICs for HEP: A mixed comparison,” J. Instrum., vol. 20, no. 12, Art. no. P12022, Dec. 2025.
[7] M. Thiriloganathan et al., “A 2.4 GHz LC-VCO fractional-N phase locked loop open-source design in 130-nm BiCMOS,” in Proc. 22nd Int. Conf. SMACD, 2026, arXiv:2607.08852.
[8] R. N. S. Raphael, A. M. Pinto, L. T. Manera, and S. Finco, “Phase-locked loop (PLL)-based frequency synthesizer for digital systems driving,” in Proc. BTSym’18, SIST vol. 140, Springer, 2019, pp. 395–406.
[9] Y. Li, K. Du, and J. Zhang, “Design of ring oscillator with temperature compensation effect,” Int. J. RF Microw. Comput.-Aided Eng., vol. 32, no. 11, Art. no. e23374, Nov. 2022.
[10] H. H. Hammam, K. M. Hassan, and S. A. Ibrahim, “An ultra-low-power process-and-temperature compensated ring oscillator,” in Proc. 9th Int. Conf. ICEEE, Alanya, Turkey, Mar. 2022.
[11] S. Zhang, A. Li, Y. Han, L. Jie, X. Han, and R. C. C. Cheung, “Temperature compensation technique for ring oscillators with tail current,” Electron. Lett., vol. 52, no. 13, pp. 1108–1110, Jun. 2016.
[12] M. Ortner and M. Punzenberger, “Systems and methods for oscillators using quadratic temperature compensation,” U.S. Patent 9 748 962 B2, Aug. 29, 2017.
[13] D. Patrinos and G. Souliotis, “A low-voltage, low-power 2.5 GHz ring oscillator with process and temperature compensation,” J. Low Power Electron. Appl., vol. 15, no. 3, Art. no. 52, Sep. 2025.
[14] M. Sivasakthi and P. Radhika, “Design and analysis of PVT tolerant hybrid current starved ring VCO with bulk driven keeper technique at 45 nm CMOS technology for the PLL application,” AEU – Int. J. Electron. Commun., vol. 173, Art. no. 154987, Jan. 2024.
[15] S. Madheswaran and R. Panneerselvam, “Design and analysis of 7-stage MOS current mode logic power gated MOSFETs in current starved VCO for the PLL application,” Int. J. Electr. Comput. Eng., vol. 14, no. 2, pp. 1398–1405, Apr. 2024.

### A Reproduction

All paths are relative to the repository pll-sky130/ (github.com/pocopepe/visualizer). Environ-ment: Arch Linux, ngspice 47, sky130B via volare (commit c6d73a35f524070e85faff4a6a9eef49553ebc2b, env/pdk.env); Python with numpy and matplotlib; netgen at ~/tools/netgen/bin/netgen (see env/NETGEN.md).

### B Tables for all 11 corners

### C Parameter list

Command (from pll-sky130/) | Produces /where the result lives
python3 scripts/corner_audit.py | Single-device | audit: | results/corner_audit/device_
corners.csv; | findings | in | results/corner_audit/
FINDINGS.md
python3 scripts/make_factorial_lib.py | Textbook corner library env/sky130_factorial.lib.spice,
env/factorial/
python3 scripts/factorial_analysis.py | VCO factorial table results/vco/factorial.csv; ordering
checks results/corner_audit/factorial_summary.json
python3 scripts/comp_factorial.py | Compensation | fit | and | verification: | results/comp/
factorial/factorial_comp_all.json scripts/run_comp_mc_sweep.sh, python3
scripts/analyze_mc.py

Monte Carlo runs results/mc_v2/; analysis results/comp/ mc_v2_analysis.txt
python3 scripts/closed_loop_campaign.py | 28 loop runs: results/loop/campaign/summary.csv (+ per-
| case JSON)
python3 scripts/make_final_numbers.py | results/final_numbers.md (all headline numbers)
python3 scripts/make_final_figures.py,
make_audit_figures.py

Figures docs/figures/final_*.png, audit_*.png

python3 docs/final_proposal/gen_ tables.py

Table fragments of this report from final_numbers.md

pdflatex final_proposal.tex | (twice, | in
docs/final_proposal/) | This report
python3 scripts/loop_check.py | Averaged behavioural loop model (cross-check of lock time)
Table | 6: | Reproduction map. | Narrative findings: | RESULTS.md, STATUS.md, docs/loop_
model.md, results/loop/FINDINGS_RETUNE.md, results/vco/FINDINGS_GRID5CORNER.md, docs/stats_ methodology.md, PROJECT_CHARTER.md (decision log).
Corner | 1st span (%) 2nd span (%) | k1 (V/◦C) | k2 (V/◦C
2
) f0 (MHz) Base span (%)
nsps (ss) | 0.91 | 0.35 −2.114 × 10⁻⁴
| | | 4.605 × 10⁻⁷
178.0 | 13.37
nspt | 0.98 | 0.38 −2.072 × 10⁻⁴
| | | 4.669 × 10⁻⁷
188.0 | 13.97
nspf | 1.10 | 0.42 −2.032 × 10⁻⁴
| | | 4.955 × 10⁻⁷
195.9 | 14.38
ntps | 0.64 | 0.24 −1.611 × 10⁻⁴
| | | 4.270 × 10⁻⁷
211.8 | 8.10
ntpt (tt) | 0.67 | 0.20 −1.543 × 10⁻⁴
| | | 4.183 × 10⁻⁷
226.2 | 8.51
ntpf | 0.77 | 0.20 −1.486 × 10⁻⁴
| | | 4.541 × 10⁻⁷
238.1 | 8.79
nfps | 0.45 | 0.12 −9.648 × 10⁻⁵
| | | 4.404 × 10⁻⁷
242.8 | 3.82
nfpt | 0.50 | 0.12 −9.020 × 10⁻⁵
| | | 4.148 × 10⁻⁷
262.7 | 4.06
nfpf (ff) | 0.59 | 0.11 −8.290 × 10⁻⁵
| | | 4.569 × 10⁻⁷
279.2 | 4.15
PDK sf (N fast, P slow) | 0.41 | 0.09 −3.404 × 10⁻⁵
| | | 4.463 × 10⁻⁷
246.2 | 1.49
PDK fs (N slow, P fast) | 1.29 | 0.49 −2.301 × 10⁻⁴
| | | 5.171 × 10⁻⁷
183.7 | 17.49

Table 7: Compensation coefficients and spans per corner (nominal, ideal source, fit at Vctrl = 0.9 V). Raw: results/comp/factorial/factorial_comp_all.json.

NMOS \ PMOS | slow | typ | fast

f at 0.9 V, 27 ◦C (MHz)
N slow | 177.99 | 188.00 | 195.91
N typ | 211.77 | 226.21 | 238.08
N fast | 242.85 | 262.71 | 279.18

f at 1.4 V, 27 ◦C (MHz)
N slow | 300.17 | 340.43 | 378.10
N typ | 314.70 | 358.05 | 398.83
N fast | 327.51 | 373.63 | 417.20

tempco at 0.9 V (ppm/ ◦C)
N slow | 1069.75 | 1117.55 | 1150.77
N typ | 648.33 | 680.76 | 703.22
N fast | 305.87 | 325.04 | 331.97

KVCO at 0.9 V (MHz/V)
N slow | 814.97 | 917.61 | 1003.13
N typ | 757.49 | 887.04 | 997.62
N fast | 655.24 | 804.01 | 935.69

KVCO/f at 0.9 V (1/V)
N slow | 4.58 | 4.88 | 5.12
N typ | 3.58 | 3.92 | 4.19
N fast | 2.70 | 3.06 | 3.35

Table 8: Textbook 3 × 3 factorial tables (VCO, tt supply, sky130B).

Case (corner, T, start) Lock (ns) fV CO (MHz) f err (%) Vlock (V) Ripple (mV) Peak V (V)

nsps, 27 ◦C, coarse | 966.8 | 226.174 | -0.012 | 0.9678 | 0.09 | 1.007
nsps, 27 ◦C, cold | 1675.0 | 226.174 | -0.012 | 0.9678 | 0.13 | 1.089
nspt, 27 ◦C, coarse | 645.3 | 226.175 | -0.011 | 0.9437 | 0.08 | 0.981
nspt, 27 ◦C, cold | 1531.2 | 226.175 | -0.011 | 0.9437 | 0.14 | 1.048
nspf, 27 ◦C, coarse | 572.8 | 226.175 | -0.011 | 0.9305 | 0.08 | 0.962
nspf, 27 ◦C, cold | 1354.4 | 226.166 | -0.015 | 0.9305 | 0.08 | 1.029
ntps, 27 ◦C, coarse | 677.5 | 226.175 | -0.011 | 0.9198 | 0.08 | 0.951
ntps, 27 ◦C, cold | 1537.0 | 226.175 | -0.011 | 0.9198 | 0.14 | 1.033
ntpt, 27 ◦C, coarse | 503.1 | 226.175 | -0.011 | 0.9 | 0.19 | 0.922
ntpt, 27 ◦C, cold | 1351.4 | 226.166 | -0.015 | 0.9 | 0.08 | 1.001
ntpf, 27 ◦C, coarse | 177.4 | 226.174 | -0.012 | 0.8884 | 0.08 | 0.906
ntpf, 27 ◦C, cold | 1318.1 | 226.183 | -0.007 | 0.8884 | 0.14 | 0.986
nfps, 27 ◦C, coarse | 386.9 | 226.175 | -0.011 | 0.8767 | 0.14 | 0.932
nfps, 27 ◦C, cold | 1390.8 | 226.175 | -0.011 | 0.8767 | 0.08 | 0.984
nfpt, 27 ◦C, coarse | 279.1 | 226.174 | -0.012 | 0.8597 | 0.08 | 0.92
nfpt, 27 ◦C, cold | 1315.8 | 226.183 | -0.007 | 0.8597 | 0.08 | 0.947
nfpf, 27 ◦C, coarse | 241.1 | 226.172 | -0.012 | 0.8494 | 0.13 | 0.915
nfpf, 27 ◦C, cold | 1282.5 | 226.175 | -0.011 | 0.8494 | 0.08 | 0.944
PDK sf, 27 ◦C, coarse | 419.3 | 226.175 | -0.011 | 0.8694 | 0.08 | 0.929
PDK sf, 27 ◦C, cold | 1387.8 | 226.175 | -0.011 | 0.8694 | 0.08 | 0.98
PDK fs, 27 ◦C, coarse | 575.5 | 226.166 | -0.015 | 0.942 | 0.08 | 0.976
PDK fs, 27 ◦C, cold | 1355.1 | 226.175 | -0.011 | 0.942 | 0.08 | 1.041
nsps, -40 ◦C, cold | 1632.8 | 226.174 | -0.012 | 0.9687 | 0.09 | 1.078
nsps, 85 ◦C, cold | 2082.7 | 226.11 | -0.04 | 0.9722 | 0.8 | 1.092
ntpt, -40 ◦C, cold | 1318.5 | 226.175 | -0.011 | 0.9119 | 0.14 | 1.01
ntpt, 85 ◦C, cold | 1417.8 | 226.166 | -0.015 | 0.8925 | 0.08 | 0.998
nfpf, -40 ◦C, cold | 1248.5 | 226.174 | -0.012 | 0.8667 | 0.11 | 0.956
nfpf, 85 ◦C, cold | 1317.4 | 226.174 | -0.012 | 0.8375 | 0.08 | 0.935

Table 9: All 28 closed-loop cases (R2 = 3.6 kΩ, C1 = 68 pF, C2 = 6.8 pF, Icp = 20 µA, N = 8; 5 µs each). All settled.

Parameter | Value
Process / PDK | sky130B, volare c6d73a35f524070e85faff4a6a9eef49553ebc2b
Simulator | ngspice 47, headless batch
Supply | 1.8 V
fref , N, fout | 28.275 MHz, 8 (3 TFFs), 226.2 MHz at Vctrl = 0.9 V (tt, 27 ◦C)
Charge pump | 20 µA (behavioural), 5× until first divider edge
Loop filter | R2 = 3.6 kΩ (was 1.7), C1 = 68 pF, C2 = 6.8 pF
Loop dynamics (tt) | fn ≈ 0.91 MHz, ζ ≈ 0.70 (was 0.33), KVCO = 887 MHz/V
VCO | 5-stage current-starved; N/P switch W/L 1.0/0.5 and 2.0/0.5 µm;
| current sources 2.0/0.5 µm; ≈ 58 µA
Tuning range (tt) | 18 MHz at 0.65 V to 358 MHz at 1.40 V
Temperature range | −40 to 85 ◦C; fit temperatures −40, −20, 0, 27, 50, 85; held-out
| −30, 10, 40, 70 ◦C
Specifications | drift ±0.3 %; lock < 2 µs; Vctrl ∈ [0.63, 1.53] V; KVCO variation
| < ±20 % (target)
Monte Carlo | tt, mismatch on, 72 chips, paired by seed, |f(85) − f(−40)|

Table 10: Parameters used throughout.
