pocopepe/visualizer/pll-sky130/docs/diagrams/vco_schematic.pdf

### Bias generator

VDD

vbiasp

Vctrl

Mpb (diode)

Mnb

### One ring stage (current-starved inverter)

VDD

nodeA

out

nodeB

in

vbiasp

Vctrl

Mp cs

Mp inv

Mn inv

Mn cs

gates of Mp cs/Mn cs are the SAME nets as the bias generator (vbiasp / Vctrl)
