pocopepe/visualizer/pll-sky130/docs/diagrams/compensation_arch.pdf

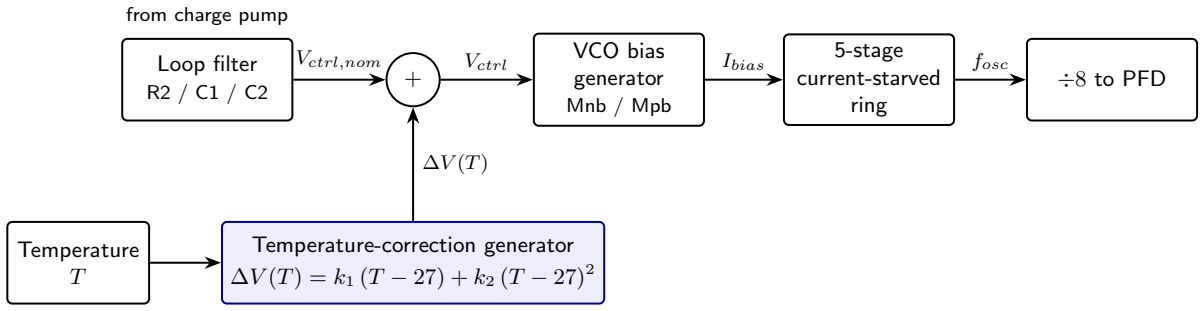
[picture p39: figure]
Loop filter; from charge pump; VCO bias generator; Mnb / Mpb; 5-stage current-starved ring; ÷8 to PFD; Temperature-correction generator ∆V (T) = k1 (T − 27) + k2 (T − 27)²; Temperature T; Vctrl,nom; Vctrl; Ibias; fosc

1st-order: k2 = 0 (linear, PTAT/CTAT-equivalent) 2nd-order: k2 ̸= 0 (curvature-matched) Coefficients fitted per process corner; an ideal behavioural source in Review 2.
