pocopepe/visualizer/pll-sky130/docs/figures/alpha.png

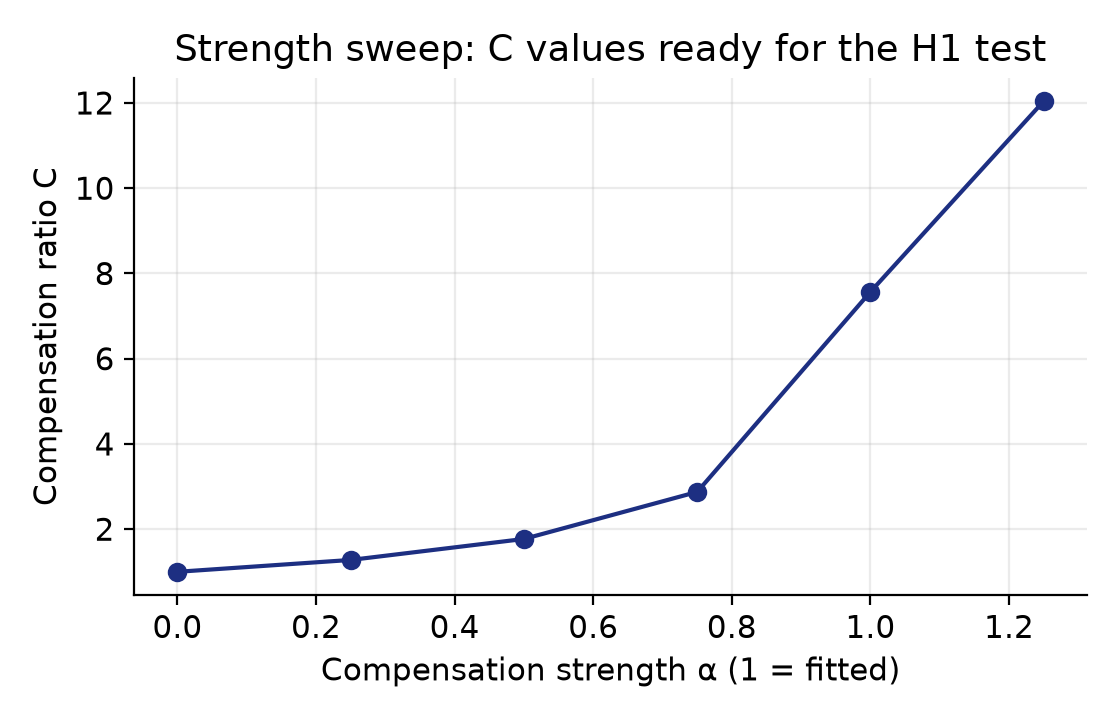
pll-sky130/docs/figures/alpha.png
