pocopepe/visualizer/pll-sky130/results/final_numbers.md

# Final numbers (generated by scripts/make_final_numbers.py from results/*; do not edit by hand)

## Compensation on 11 corners (nominal, ideal behavioural source; least-squares fit on measured f(T,V); verified by simulation)

| corner | f(0.9 V, 27 C) MHz | baseline span % | 1st-order span % | 2nd-order span % | 2nd max dev % | held-out max dev % | C = base/2nd | k1 (V/C) | k2 (V/C^2) | meets +/-0.3 % |
|---|---|---|---|---|---|---|---|---|---|---|
| nsps | 178.0 | 13.37 | 0.91 | 0.35 | 0.277 | 0.175 | 38.4 | -2.1143e-04 | 4.6054e-07 | yes |
| nspt | 188.0 | 13.97 | 0.98 | 0.38 | 0.301 | 0.201 | 37.2 | -2.0724e-04 | 4.6694e-07 | NO |
| nspf | 195.9 | 14.38 | 1.10 | 0.42 | 0.325 | 0.223 | 34.3 | -2.0316e-04 | 4.9546e-07 | NO |
| ntps | 211.8 | 8.10 | 0.64 | 0.24 | 0.195 | 0.109 | 33.6 | -1.6108e-04 | 4.2703e-07 | yes |
| ntpt | 226.2 | 8.51 | 0.67 | 0.20 | 0.162 | 0.091 | 43.2 | -1.5426e-04 | 4.1835e-07 | yes |
| ntpf | 238.1 | 8.79 | 0.77 | 0.20 | 0.168 | 0.097 | 43.7 | -1.4857e-04 | 4.5413e-07 | yes |
| nfps | 242.8 | 3.82 | 0.45 | 0.12 | 0.079 | 0.034 | 31.0 | -9.6480e-05 | 4.4038e-07 | yes |
| nfpt | 262.7 | 4.06 | 0.50 | 0.12 | 0.102 | 0.041 | 33.3 | -9.0201e-05 | 4.1481e-07 | yes |
| nfpf | 279.2 | 4.15 | 0.59 | 0.11 | 0.093 | 0.035 | 37.0 | -8.2900e-05 | 4.5687e-07 | yes |
| pdk_sf | 246.2 | 1.49 | 0.41 | 0.09 | 0.051 | 0.036 | 15.9 | -3.4036e-05 | 4.4625e-07 | yes |
| pdk_fs | 183.7 | 17.49 | 1.29 | 0.49 | 0.360 | 0.251 | 35.8 | -2.3013e-04 | 5.1708e-07 | NO |

## Closed loop (R2 = 3.6 kOhm, C1 68 pF, C2 6.8 pF, Icp 20 uA, N = 8; spec lock < 2000 ns; lock = V_ctrl within +/-2 % of final)

| case | lock ns | f_VCO MHz | f error % | V_ctrl lock V | ripple mV | peak V | settled |
|---|---|---|---|---|---|---|---|
| nsps_T27_coarse | 966.8 | 226.174 | -0.012 | 0.9678 | 0.09 | 1.007 | True |
| nsps_T27_cold | 1675.0 | 226.174 | -0.012 | 0.9678 | 0.13 | 1.089 | True |
| nspt_T27_coarse | 645.3 | 226.175 | -0.011 | 0.9437 | 0.08 | 0.981 | True |
| nspt_T27_cold | 1531.2 | 226.175 | -0.011 | 0.9437 | 0.14 | 1.048 | True |
| nspf_T27_coarse | 572.8 | 226.175 | -0.011 | 0.9305 | 0.08 | 0.962 | True |
| nspf_T27_cold | 1354.4 | 226.166 | -0.015 | 0.9305 | 0.08 | 1.029 | True |
| ntps_T27_coarse | 677.5 | 226.175 | -0.011 | 0.9198 | 0.08 | 0.951 | True |
| ntps_T27_cold | 1537.0 | 226.175 | -0.011 | 0.9198 | 0.14 | 1.033 | True |
| ntpt_T27_coarse | 503.1 | 226.175 | -0.011 | 0.9 | 0.19 | 0.922 | True |
| ntpt_T27_cold | 1351.4 | 226.166 | -0.015 | 0.9 | 0.08 | 1.001 | True |
| ntpf_T27_coarse | 177.4 | 226.174 | -0.012 | 0.8884 | 0.08 | 0.906 | True |
| ntpf_T27_cold | 1318.1 | 226.183 | -0.007 | 0.8884 | 0.14 | 0.986 | True |
| nfps_T27_coarse | 386.9 | 226.175 | -0.011 | 0.8767 | 0.14 | 0.932 | True |
| nfps_T27_cold | 1390.8 | 226.175 | -0.011 | 0.8767 | 0.08 | 0.984 | True |
| nfpt_T27_coarse | 279.1 | 226.174 | -0.012 | 0.8597 | 0.08 | 0.92 | True |
| nfpt_T27_cold | 1315.8 | 226.183 | -0.007 | 0.8597 | 0.08 | 0.947 | True |
| nfpf_T27_coarse | 241.1 | 226.172 | -0.012 | 0.8494 | 0.13 | 0.915 | True |
| nfpf_T27_cold | 1282.5 | 226.175 | -0.011 | 0.8494 | 0.08 | 0.944 | True |
| pdk_sf_T27_coarse | 419.3 | 226.175 | -0.011 | 0.8694 | 0.08 | 0.929 | True |
| pdk_sf_T27_cold | 1387.8 | 226.175 | -0.011 | 0.8694 | 0.08 | 0.98 | True |
| pdk_fs_T27_coarse | 575.5 | 226.166 | -0.015 | 0.942 | 0.08 | 0.976 | True |
| pdk_fs_T27_cold | 1355.1 | 226.175 | -0.011 | 0.942 | 0.08 | 1.041 | True |
| nsps_T-40_cold | 1632.8 | 226.174 | -0.012 | 0.9687 | 0.09 | 1.078 | True |
| nsps_T85_cold | 2082.7 | 226.11 | -0.04 | 0.9722 | 0.8 | 1.092 | True |
| ntpt_T-40_cold | 1318.5 | 226.175 | -0.011 | 0.9119 | 0.14 | 1.01 | True |
| ntpt_T85_cold | 1417.8 | 226.166 | -0.015 | 0.8925 | 0.08 | 0.998 | True |
| nfpf_T-40_cold | 1248.5 | 226.174 | -0.012 | 0.8667 | 0.11 | 0.956 | True |
| nfpf_T85_cold | 1317.4 | 226.174 | -0.012 | 0.8375 | 0.08 | 0.935 | True |

## Single-device audit (ngspice lib, W/L 2/0.5 um)

| corner | T C | NMOS Id 0.9 V uA | PMOS Id 0.9 V uA | NMOS Id 1.8 V uA | PMOS Id 1.8 V uA | NMOS Vth V | PMOS |Vth| V |
|---|---|---|---|---|---|---|---|
| ss | -40 | 24.6 | 0.005 | 492.9 | 67.0 | 0.7508 | 1.4121 |
| ss | 27 | 27.9 | 0.112 | 401.2 | 69.9 | 0.6945 | 1.3376 |
| ss | 85 | 29.7 | 0.672 | 341.9 | 72.1 | 0.6541 | 1.2663 |
| sf | -40 | 49.3 | 0.003 | 580.2 | 66.4 | 0.6895 | 1.4268 |
| sf | 27 | 51.3 | 0.082 | 480.0 | 68.5 | 0.6333 | 1.3548 |
| sf | 85 | 52.3 | 0.529 | 413.5 | 70.5 | 0.5924 | 1.2868 |
| tt | -40 | 33.8 | 0.011 | 533.7 | 82.8 | 0.7255 | 1.3957 |
| tt | 27 | 36.9 | 0.211 | 438.2 | 86.5 | 0.6693 | 1.3229 |
| tt | 85 | 38.5 | 1.154 | 375.5 | 90.3 | 0.6286 | 1.2561 |
| fs | -40 | 21.9 | 0.034 | 489.2 | 99.6 | 0.7619 | 1.3571 |
| fs | 27 | 25.3 | 0.518 | 397.2 | 104.4 | 0.7054 | 1.2800 |
| fs | 85 | 27.2 | 2.300 | 337.9 | 109.0 | 0.6646 | 1.2088 |
| ff | -40 | 45.2 | 0.024 | 575.2 | 99.0 | 0.7005 | 1.3740 |
| ff | 27 | 47.7 | 0.403 | 475.4 | 103.2 | 0.6441 | 1.3000 |
| ff | 85 | 48.9 | 1.911 | 409.2 | 107.8 | 0.6032 | 1.2324 |

## Textbook-ordering checks (results/corner_audit/factorial_summary.json)

- PASS: f(0.9 V, 27C) MHz: increases with NMOS strength (each PMOS state)
- PASS: f(0.9 V, 27C) MHz: increases with PMOS strength (each NMOS state)
- PASS: f(0.9 V, 27C) MHz: nsps is the minimum, nfpf the maximum of the 9
- PASS: f(1.4 V, 27C) MHz: increases with NMOS strength (each PMOS state)
- PASS: f(1.4 V, 27C) MHz: increases with PMOS strength (each NMOS state)
- PASS: f(1.4 V, 27C) MHz: nsps is the minimum, nfpf the maximum of the 9
- PASS: tempco decreases with NMOS strength (each PMOS state)
- PASS: tempco: nfpf < ntpt < nsps
- PASS: f(0.9 V, 27C) MHz: PDK sf inside [ss, ff] envelope
- PASS: f(0.9 V, 27C) MHz: PDK fs inside [ss, ff] envelope
- PASS: f(1.4 V, 27C) MHz: PDK sf inside [ss, ff] envelope
- PASS: f(1.4 V, 27C) MHz: PDK fs inside [ss, ff] envelope
- FAIL: tempco: PDK sf (112) inside [ff, ss] = [332, 1070]
- FAIL: tempco: PDK fs (1399) inside [ff, ss] = [332, 1070]

## 3x3 factorial tables (rows NMOS slow/typ/fast; columns PMOS slow/typ/fast)

**f(0.9 V, 27C) MHz**

| | P slow | P typ | P fast |
|---|---|---|---|
| N slow | 177.99 | 188.00 | 195.91 |
| N typ | 211.77 | 226.21 | 238.08 |
| N fast | 242.85 | 262.71 | 279.18 |

**f(1.4 V, 27C) MHz**

| | P slow | P typ | P fast |
|---|---|---|---|
| N slow | 300.17 | 340.43 | 378.10 |
| N typ | 314.70 | 358.05 | 398.83 |
| N fast | 327.51 | 373.63 | 417.20 |

**tempco ppm/C @0.9V**

| | P slow | P typ | P fast |
|---|---|---|---|
| N slow | 1069.75 | 1117.55 | 1150.77 |
| N typ | 648.33 | 680.76 | 703.22 |
| N fast | 305.87 | 325.04 | 331.97 |

**K_VCO MHz/V @0.9V**

| | P slow | P typ | P fast |
|---|---|---|---|
| N slow | 814.97 | 917.61 | 1003.13 |
| N typ | 757.49 | 887.04 | 997.62 |
| N fast | 655.24 | 804.01 | 935.69 |

**K_VCO/f  1/V @0.9V**

| | P slow | P typ | P fast |
|---|---|---|---|
| N slow | 4.58 | 4.88 | 5.12 |
| N typ | 3.58 | 3.92 | 4.19 |
| N fast | 2.70 | 3.06 | 3.35 |
