pocopepe/visualizer/pll-sky130/results/loop/FINDINGS.md

# Closed-Loop Lock — Review 1 Milestone Result

**Result: the loop locks.** Nominal corner (tt, 27°C), design point from `docs/loop_model.md`.

> **Retune note (2026-10-11).** Every number in this file is for the **original loop filter, R2 = 1.7 kΩ** (the Review-1 design), and is kept as the "before". The loop filter was subsequently retuned to **R2 = 3.6 kΩ** and verified at transistor level: tt coarse-start lock 577 → 503 ns, final frequency error 0.78 % → 0.008 %, V_ctrl ripple 8.6 → 0.35 mV p-p, and the loop now locks inside 2 µs at all five corners (the original had not settled by 2 µs at ff/sf/fs/ss). See `results/loop/FINDINGS_RETUNE.md` and `docs/loop_model.md`. The testbench `blocks/top/tb_closed_loop.spice` now instantiates r2=3.6k.

> **Erratum (2026-10-11).** This file originally compared 577 ns to a "~450 ns analytical model" prediction and explained the gap by PFD reset delay and discrete pumping. That prediction came from an arithmetic error in `docs/loop_model.md` (missing 1/(2π)); it matched only by coincidence, and the gap explanation is withdrawn. The corrected original loop (R2 = 1.7 kΩ) is underdamped (fn ≈ 0.9 MHz, ζ ≈ 0.33, PM ≈ 30-33°), consistent with the overshoot to ~0.92 V seen here. The 577 ns measurement is unaffected and **matches an independent averaged behavioural model (573 ns, `scripts/loop_check.py`)**.

| Quantity (original R2 = 1.7 kΩ) | Measured | Target / Predicted |
|---|---|---|
| Lock time (vctrl enters and stays within ±2% of final value) | **577 ns** | <2µs (charter); 573 ns (independent averaged model; the original "450 ns analytical" is withdrawn) |
| Settled vctrl | 0.902 V | 0.9 V design point |
| Settled div_fb frequency | 28.515 MHz | f_ref = 28.275 MHz (0.85% high) |
| Settled VCO output frequency | 227.96 MHz | N·f_ref = 226.2 MHz (0.78% high) |

The residual frequency offset (~0.8%) was attributed here to charge-pump/PFD limit-cycle ripple. The retune data suggests it was mostly the underdamped loop not yet having settled at 2 µs: with R2 = 3.6 kΩ the same run ends 0.008 % from target with 0.35 mV ripple (vs 8.6 mV), though this was not isolated by a dedicated experiment. The measured 577ns agrees with the independent averaged behavioural model (573 ns) run on the measured tuning curve from the same 0.85 V start, which is the check that matters. (Earlier text here attributed a 577-vs-450 ns gap to PFD reset delay and discrete pumping; that explanation is withdrawn together with the 450 ns figure.)

Raw data: `run4_icfix.txt` is the accepted result. `run1_acquisition_deadzone.txt`, `run2_finelock.txt`, `run3_holdfix.txt` are kept as the debugging trail, not as results — see below.

## Two real bugs found and fixed getting here — both worth keeping on record

### Bug 1: SPICE current-source node-order convention (run1 → polarity fix)

First attempt: `Bcp ctrl vss I = (up ? +icp : 0) - (dn ? +icp : 0)`. Result: vctrl ramped **monotonically negative** forever regardless of UP/DN — the loop was firing in the right logical sense (UP dominant when it should be) but the physical effect was backwards.

Root cause, confirmed with an isolated 4-line test *before* touching the real circuit again (see `docs/loop_model.md` note, and the throwaway `/tmp/polarity_test*.cir` files): in ngspice's B-source, `Bxxx n1 n2 I=expr` defines current flowing n1→n2 *inside* the source, which by KCL **draws current out of n1** when positive — the opposite of the naive "sources positive current into n1" reading. Verified empirically:
- `Btest ctrl 0 I=1u` on a capacitor from ctrl to ground: ctrl went *negative*.
- `Btest 0 ctrl I=1u` (node order swapped): ctrl went *positive*, as intended.

Fix: swap the node order in `charge_pump.spice` (`Bcp vss ctrl I=...`, not `Bcp ctrl vss I=...`). Lesson worth generalizing: when a SPICE polarity convention is in doubt, a 5-line isolated test costs seconds; guessing costs a 3-minute full-loop rerun per wrong guess, and this specific one *did* need two guesses.

### Bug 2: inconsistent capacitor initial condition (run2/run3 → the real dead-zone cause)

After fixing Bug 1, vctrl still collapsed from its `.ic` value down to ~0.1V within the first ~40ns on every run, before recovering and slowly re-climbing. First hypothesis (wrong, but worth recording *why* it was a reasonable first guess): the PFD/divider's ~30+ internal gate nodes all cold-start at an unstaggered 0V (unlike the VCO, which got explicit staggered `.ic`s after the standalone-VCO critique), so a startup logic glitch asserting DN seemed plausible. Added a 50ns charge-pump hold gate to test this — **the collapse still happened, fully, within that 50ns window**. That result is what disproved the hypothesis rather than confirming it: if the charge pump was disabled and vctrl still collapsed, the charge pump wasn't the cause.

Actual cause: `.ic v(vctrl)=0.85` was set, but the loop filter's own internal node (`nlf`, between R2 and C1) was never given a matching `.ic` and defaulted to 0V. With the charge pump silent, the loop filter is just two capacitors (C1=68pF behind R2, C2=6.8pF direct) with no other source, and they simply redistribute their initial charge: `V_final = (C1·0 + C2·0.85)/(C1+C2) = 0.077V`. Measured collapse point (~0.098-0.13V across the two flawed runs) matches this hand calculation closely. Fix: add `v(xlf.nlf)=0.85` to the `.ic` line, consistent with `v(vctrl)`. Lesson: **every reactive internal node touched by a nontrivial `.ic` needs its own consistent `.ic`, not just the nodes you're deliberately trying to set** — this is the same category of mistake as the VCO's original synchronous-cold-start bug, just one level deeper (a passive RC network this time, not a digital latch).

## What this result does and does not establish

**Does establish:** the topology (PFD → behavioral CP → passive LF → transistor-level ring VCO → transistor-level ÷8 divider) closes into a working, locking negative-feedback loop, with a lock time that matches an independent averaged behavioural model (573 ns vs 577 ns; the Review-1 closed-form prediction was erroneous, see erratum above), at one operating point (tt corner, 27°C, starting near the nominal bias).

**Does not yet establish:**
- Lock across PVT (this run is tt/27°C only — Review 2 scope).
- Robustness to a cold start *outside* the VCO's usable range (below ~0.65V). `run1_acquisition_deadzone.txt` (from before the IC fix, but still informative on this point) showed that starting below ~0.65V (where the VCO is under 18 MHz, so the divided clock is effectively absent; there is no hard oscillation floor, corrected 2026-10-11) drives the loop into a multi-microsecond charge-pump-integration dead zone before the divider even starts toggling — directly compounding the VCO lock-range finding from `results/vco/FINDINGS.md`. This remains a real, open risk for anything other than a "coarse-tuned start" — see `STATUS.md` decision #1.
- Any noise/jitter/phase-noise behavior (the charge pump is still the idealized behavioral model from `blocks/charge_pump/charge_pump.spice` — transistor-level CP with real mismatch is deferred to Review 2, where it's needed anyway for the Monte Carlo study).
- PFD dead-zone quantified (the ~0.8% frequency offset is consistent with it, but not isolated and measured directly).
