pocopepe/visualizer/pll-sky130/results/corner_audit/device_corners.csv

corner | temp_C | nmos_Id_0p9_uA | pmos_Id_0p9_uA | nmos_Id_1p8_uA | pmos_Id_1p8_uA | nmos_Vth_V | pmos_Vth_V
ss | -40 | 24.5878 | 0.0053 | 492.898 | 66.9611 | 0.7508 | 1.4121
ss | 27 | 27.8535 | 0.1118 | 401.2258 | 69.8793 | 0.6945 | 1.3376
ss | 85 | 29.6717 | 0.6716 | 341.9011 | 72.1258 | 0.6541 | 1.2663
sf | -40 | 49.3039 | 0.0034 | 580.1882 | 66.3782 | 0.6895 | 1.4268
sf | 27 | 51.3075 | 0.0822 | 480.0472 | 68.4533 | 0.6333 | 1.3548
sf | 85 | 52.3049 | 0.5288 | 413.4634 | 70.4588 | 0.5924 | 1.2868
tt | -40 | 33.8028 | 0.0112 | 533.737 | 82.774 | 0.7255 | 1.3957
tt | 27 | 36.8713 | 0.2112 | 438.1646 | 86.476 | 0.6693 | 1.3229
tt | 85 | 38.5435 | 1.1542 | 375.4837 | 90.3438 | 0.6286 | 1.2561
fs | -40 | 21.8565 | 0.0335 | 489.2322 | 99.6204 | 0.7619 | 1.3571
fs | 27 | 25.2773 | 0.518 | 397.2021 | 104.3744 | 0.7054 | 1.28
fs | 85 | 27.216 | 2.2999 | 337.8928 | 109.0199 | 0.6646 | 1.2088
ff | -40 | 45.178 | 0.0242 | 575.2198 | 99.023 | 0.7005 | 1.374
ff | 27 | 47.6541 | 0.4025 | 475.4018 | 103.1945 | 0.6441 | 1.3
ff | 85 | 48.9473 | 1.9114 | 409.1815 | 107.7586 | 0.6032 | 1.2324
