pocopepe/visualizer/pll-sky130/results/loop/campaign/summary.csv

case | corner | lib | temp_C | start | lock_ns | vctrl_final_V | f_vco_MHz | f_err_pct | ripple_mV | peak_V | drift_last_us_mV | tstop_ns | settled
nsps_T27_coarse | nsps | fact | 27 | coarse | 966.8 | 0.9678 | 226.174 | -0.012 | 0.09 | 1.007 | 0.01 | 5000 | True
nsps_T27_cold | nsps | fact | 27 | cold | 1675.0 | 0.9678 | 226.174 | -0.012 | 0.13 | 1.089 | 0.08 | 5000 | True
nspt_T27_coarse | nspt | fact | 27 | coarse | 645.3 | 0.9437 | 226.175 | -0.011 | 0.08 | 0.981 | 0.0 | 5000 | True
nspt_T27_cold | nspt | fact | 27 | cold | 1531.2 | 0.9437 | 226.175 | -0.011 | 0.14 | 1.048 | 0.01 | 5000 | True
nspf_T27_coarse | nspf | fact | 27 | coarse | 572.8 | 0.9305 | 226.175 | -0.011 | 0.08 | 0.962 | 0.0 | 5000 | True
nspf_T27_cold | nspf | fact | 27 | cold | 1354.4 | 0.9305 | 226.166 | -0.015 | 0.08 | 1.029 | 0.0 | 5000 | True
ntps_T27_coarse | ntps | fact | 27 | coarse | 677.5 | 0.9198 | 226.175 | -0.011 | 0.08 | 0.951 | 0.0 | 5000 | True
ntps_T27_cold | ntps | fact | 27 | cold | 1537.0 | 0.9198 | 226.175 | -0.011 | 0.14 | 1.033 | 0.03 | 5000 | True
ntpt_T27_coarse | ntpt | fact | 27 | coarse | 503.1 | 0.9 | 226.175 | -0.011 | 0.19 | 0.922 | 0.04 | 5000 | True
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
