pocopepe/visualizer/pll-sky130/results/loop/run1_acquisition_deadzone_vctrl_subsampled.csv

3.59431753e-09 | 5.25307610e-01
7.59431753e-09 | 3.89876812e-01
1.15943175e-08 | 2.97479666e-01
1.55943175e-08 | 2.34591214e-01
1.94760000e-08 | 1.92941132e-01
2.34760000e-08 | 1.63737123e-01
2.74760000e-08 | 1.44096853e-01
3.14760000e-08 | 1.30999401e-01
3.54210000e-08 | 1.22472544e-01
3.93610000e-08 | 1.16943852e-01
4.33610000e-08 | 1.13428239e-01
4.73610000e-08 | 1.11361155e-01
5.13610000e-08 | 1.10284904e-01
5.52470000e-08 | 1.09890567e-01
5.92470000e-08 | 1.09944881e-01
6.32470000e-08 | 1.10319839e-01
6.72470000e-08 | 1.10914145e-01
7.11320000e-08 | 1.11635481e-01
7.51320000e-08 | 1.12480045e-01
7.91320000e-08 | 1.13395598e-01
8.31320000e-08 | 1.14359714e-01
8.71320000e-08 | 1.15357050e-01
9.10180000e-08 | 1.16347796e-01
9.50180000e-08 | 1.17383037e-01
9.90180000e-08 | 1.18429029e-01
1.03018000e-07 | 1.19482374e-01
1.06903000e-07 | 1.20510267e-01
1.10903000e-07 | 1.21572003e-01
1.14903000e-07 | 1.22636118e-01
1.18903000e-07 | 1.23701861e-01
1.22903000e-07 | 1.24768718e-01
1.26789000e-07 | 1.25805901e-01
1.30789000e-07 | 1.26874028e-01
1.34789000e-07 | 1.27942516e-01
1.38789000e-07 | 1.29011250e-01
1.42674000e-07 | 1.30049420e-01
1.46674000e-07 | 1.31118435e-01
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
