pocopepe/visualizer/pll-sky130/results/loop/run2_finelock_vctrl_subsampled.csv

3.65000000e-09 | 6.33418455e-01
7.65000000e-09 | 4.68366164e-01
1.16500000e-08 | 3.55567172e-01
1.56500000e-08 | 2.78684651e-01
1.95360000e-08 | 2.27641055e-01
2.35360000e-08 | 1.91821179e-01
2.75360000e-08 | 1.67653960e-01
3.15360000e-08 | 1.51458948e-01
3.54710000e-08 | 1.40858733e-01
3.94210000e-08 | 1.33869009e-01
4.34210000e-08 | 1.29350606e-01
4.74210000e-08 | 1.26597407e-01
5.14210000e-08 | 1.25051764e-01
5.53070000e-08 | 1.24343862e-01
5.93070000e-08 | 1.24176086e-01
6.33070000e-08 | 1.24399098e-01
6.73070000e-08 | 1.24889445e-01
7.11920000e-08 | 1.25541344e-01
7.51920000e-08 | 1.26336705e-01
7.91920000e-08 | 1.27218592e-01
8.31920000e-08 | 1.28159670e-01
8.71920000e-08 | 1.29141241e-01
9.10780000e-08 | 1.30121452e-01
9.50780000e-08 | 1.31149230e-01
9.90780000e-08 | 1.32190113e-01
1.03078000e-07 | 1.33239962e-01
1.06963000e-07 | 1.34265520e-01
1.10963000e-07 | 1.35325600e-01
1.14963000e-07 | 1.36388584e-01
1.18963000e-07 | 1.37453554e-01
1.22963000e-07 | 1.38519883e-01
1.26849000e-07 | 1.39556715e-01
1.30849000e-07 | 1.40624596e-01
1.34849000e-07 | 1.41692917e-01
1.38849000e-07 | 1.42761539e-01
1.42734000e-07 | 1.43799637e-01
1.46734000e-07 | 1.44868603e-01
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
