pocopepe/visualizer/pll-sky130/results/loop/run3_holdfix_vctrl_subsampled.csv

3.65000000e-09 | 6.24625918e-01
7.65000000e-09 | 4.52114080e-01
1.16500000e-08 | 3.33870094e-01
1.56500000e-08 | 2.52928067e-01
1.95360000e-08 | 1.98850300e-01
2.35360000e-08 | 1.60549072e-01
2.75360000e-08 | 1.34347069e-01
3.15360000e-08 | 1.16422475e-01
3.54710000e-08 | 1.04324776e-01
3.94210000e-08 | 9.59714836e-02
4.34210000e-08 | 9.01701230e-02
4.74210000e-08 | 8.62014492e-02
5.14210000e-08 | 8.74336323e-02
5.53070000e-08 | 9.42230691e-02
5.93070000e-08 | 9.93648493e-02
6.33070000e-08 | 1.03219947e-01
6.73070000e-08 | 1.06194879e-01
7.11920000e-08 | 1.08506002e-01
7.51920000e-08 | 1.10476772e-01
7.91920000e-08 | 1.12162712e-01
8.31920000e-08 | 1.13653811e-01
8.71920000e-08 | 1.15011628e-01
9.10780000e-08 | 1.16243150e-01
9.50780000e-08 | 1.17448900e-01
9.90780000e-08 | 1.18611523e-01
1.03078000e-07 | 1.19744647e-01
1.06963000e-07 | 1.20825813e-01
1.10963000e-07 | 1.21925284e-01
1.14963000e-07 | 1.23015209e-01
1.18963000e-07 | 1.24098606e-01
1.22963000e-07 | 1.25177537e-01
1.26849000e-07 | 1.26222784e-01
1.30849000e-07 | 1.27296614e-01
1.34849000e-07 | 1.28369002e-01
1.38849000e-07 | 1.29440405e-01
1.42734000e-07 | 1.30480357e-01
1.46734000e-07 | 1.31550636e-01
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
