pocopepe/visualizer/pll-sky130/results/vco/factorial.csv

corner | temp_C | vctrl_V | freq_mhz
nsps | 50 | 0.9 | 181.55
nsps | 27 | 1.1 | 270.171
nsps | 27 | 0.925 | 197.806
nsps | -20 | 0.9 | 167.587
nsps | 27 | 1.25 | 289.651
nsps | 27 | 0.875 | 156.447
nsps | 0 | 0.9 | 172.586
nsps | 27 | 0.9 | 177.993
nsps | 27 | 0.8 | 89.545
nsps | 27 | 0.85 | 133.848
nsps | 27 | 0.7 | 25.726
nsps | 85 | 0.9 | 185.404
nsps | 27 | 0.65 | 10.469
nsps | -40 | 0.9 | 161.603
nsps | 27 | 0.95 | 215.345
nsps | 27 | 1.4 | 300.17
nspt | -40 | 0.9 | 169.928
nspt | -20 | 0.9 | 176.54
nspt | 50 | 0.9 | 191.913
nspt | 27 | 0.925 | 210.577
nspt | 27 | 0.9 | 187.997
nspt | 0 | 0.9 | 182.052
nspt | 27 | 0.7 | 26.21
nspt | 27 | 0.875 | 163.975
nspt | 27 | 0.8 | 92.587
nspt | 27 | 0.85 | 139.391
nspt | 27 | 0.95 | 231.152
nspt | 27 | 1.1 | 301.755
nspt | 85 | 0.9 | 196.19
nspt | 27 | 0.65 | 10.517
nspt | 27 | 1.25 | 326.947
nspt | 27 | 1.4 | 340.426
nspf | 27 | 0.9 | 195.911
nspf | -20 | 0.9 | 183.575
nspf | -40 | 0.9 | 176.441
nspf | 27 | 0.7 | 26.484
nspf | 0 | 0.9 | 189.517
nspf | 50 | 0.9 | 200.098
nspf | 27 | 0.65 | 10.488
nspf | 85 | 0.9 | 204.622
nspf | 27 | 0.8 | 95.078
nspf | 27 | 0.85 | 143.834
nspf | 27 | 0.875 | 169.872
nspf | 27 | 0.95 | 244.147
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
