pocopepe/visualizer/pll-sky130/docs/diagrams/acq_boost.pdf

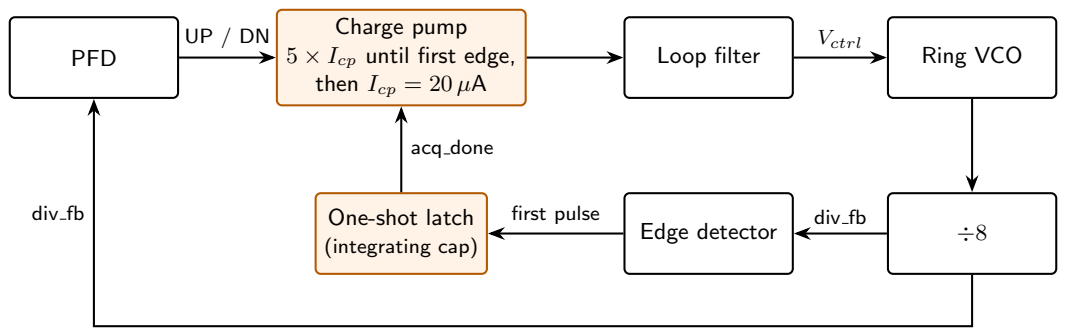
[picture p63: page 1]
PFD; Loop filter; Ring VCO; Edge detector; Vctrl; first pulse; div fb; acq done

Charge pump
5 × Icp until first edge,
then Icp = 20 µA

One-shot latch
(integrating cap)
