pocopepe/visualizer/(commit log)

2026-09-01 Fold pll-sky130 in as tracked files (was a broken nested-repo gitlink)
    pll-sky130 previously had its own .git, so the outer repo only recorded it
    as an empty submodule-style reference with no .gitmodules -- pushing would
    not have brought along any of the actual work. Removed the nested .git and
    re-added everything as normal tracked files.
    Also adds:
    - HOW_TO_NAVIGATE.md at repo root: directory map + read-order for newcomers
    - pll-sky130/cheatsheet.txt: plain-language explainer of the whole project
    - docs/review1_summary.pdf: 2-page faculty-facing summary (vs. the 10-page
    full report), with a PLL block diagram and a transistor-level VCO
    schematic, both rendered from circuitikz sources ma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
    [run1_acquisition_deadzone_vctrl_subsampled.csv, run2_finelock_vctrl_subsampled.csv, run3_holdfix_vctrl_subsampled.csv, sweep_results_v2.csv]
2026-09-29 Review 2 (in progress): full 5-corner grid, compensation network, stats methodology
    - Full VCO PVT grid across ALL 5 sky130 corners (tt/ff/ss/sf/fs), not the
    3-corner spot-check from Review 1. Corrects the reported tempco spread:
    real range is 112-1399 ppm/C (12.5x), not 332-1070 (3.4x) -- the worst
    corner (fs) wasn't checked before.
    - Second research axis added: curvature-matched (2nd-order) temperature
    compensation. Novelty-checked via a dedicated research pass BEFORE
    committing to this as a claim -- found a 2017 Infineon patent
    (9,748,962 B2) already covers generic linear+quadratic oscillator
    compensation, so narrowed the claim to what's actually still open:
    ring-VCO + clo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
    [grid5corner.csv]
2026-09-29 Review 2 complete: per-corner compensation, cold-start fix, H1 pipeline, closing docs
    Closes out every Review 2 checklist item -- delivered, or explicitly
    deferred to Review 3 with a stated reason (STATUS.md has the full list).
    Delivered:
    - Per-corner compensation refit (all 5 corners, not just tt): every corner
    improves at both 1st- and 2nd-order compensation. 2nd-order residuals
    0.10%-5.31%, C ranges 3.30x-40.28x across corners -- confirms the
    C(corner) decision with data, not just motivates it.
    - Cold-start acquisition dead zone (open risk since Review 1) fixed and
    verified: 5x-boosted charge pump (charge_pump_acq.spice) that reverts to
    nominal current on the divider's first ed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
2026-09-29 Review 2: correct MC statistics, validate per-corner fits, fix citations, final deck
    Self-review before Review 2 found and fixed:
    - analyze_mc.py compared SIGNED drift, so 1st- vs 2nd-order looked
    significant at n=12 only because 1st-order over-corrects (sign flip).
    Now tests |drift|, and builds pairs per seed (the old code could
    misalign pairs if one arm had a missing point). Re-ran at n=30:
    2nd-order is significantly better, |drift| -2.48 MHz,
    95% CI [0.81, 4.15], t-test and Wilcoxon agree, 23/30 seeds.
    - Per-corner compensation fits were in-sample; re-simulated each at 4
    held-out temperatures never used in fitting -- all stay inside the
    fitted envelope.
    - The +/-0.3% spec is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
2026-09-30 Review 2 deck: 24 slides with native charts and architecture diagrams
    - New slides: VCO schematic + tuning, compensation architecture, cold-start
    boost, methodology flow, drift/tempco, curvature, tt compensation,
    per-corner residuals, lock transient, Monte Carlo charts, key numbers
    - Figure pipeline: make_figdata.py -> figdata.json -> make_figures.py
    - Fix sf baseline span 1.40% -> 1.48% (max-min, not endpoint) and
    1st-order MC mean 5.86 -> 5.85 MHz (5.855 rounds down)
2026-09-30 Review 2 reading guide; fix VCO schematic wiring and diagram labels
    - docs/review2_guide: 10-page cheatsheet (story, per-block explanation,
    results with figures, slide talking points, numbers, examiner Q&A)
    - vco_schematic: Mn_cs gate was drawn tied to bias-gen VSS; netlist has
    vbiasn = vctrl. Redrawn to match, titles/labels no longer overlap
    - pll_block_diagram: labels moved off wires; deck slide 5 now uses it
2026-10-11 Correct numbers found wrong on audit: sf/fs labels, K_VCO, loop damping, oscillation floor
    - sf = fast-NMOS/slow-PMOS, fs = slow-NMOS/fast-PMOS in this PDK (labels were reversed);
    tempco ranks with NMOS drive, sign flips at Vctrl=1.4 V (-816 ppm/C)
    - local K_VCO at 0.9 V is ~887 MHz/V (tt), not 669 (whole-curve quadratic fit)
    - Review-1 loop design dropped 1/(2*pi): zeta ~0.33, fn ~0.9 MHz, PM ~30 deg, not 0.72/2 MHz/70;
    measured lock 577 ns confirmed by independent averaged model (573 ns)
    - no hard 0.63 V oscillation floor (0.63 MHz at 0.5 V, long-window sims)
    - deck 26 slides (+why-corners, +loop dynamics), guide 12 pages, erratum notes in docs/report
    - spans, MC statistics, 577/839 ns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
2026-10-11 Retune loop filter (R2 1.7k -> 3.6k), verify at all 5 corners; final-review readiness
    - Review-1 loop design dropped 1/(2pi): zeta was 0.33. R2=3.6k gives zeta ~0.70
    - transistor-level: tt coarse lock 577->503 ns, ripple 8.6->0.35 mV, residual freq error
    0.78%->0.008%; 0 V cold start 839->1352 ns (cost, still <2 us); all five corners lock
    (ff 241, sf 419, tt 503, fs 576, ss 967 ns); original loop had not settled at ff/sf/fs/ss by 2 us
    - deck 27 slides (+lock across corners), guide 15 pages, docs/diagrams/figures updated
    - netgen built from source (env/NETGEN.md); docs/FINAL_REVIEW_READINESS.md
    - raw retune waveforms gitignored (~325 MB); netlists + analysis json kept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
2026-10-20 Final-review audit: corner ordering, corrected compensation, Monte Carlo n=72, 28-run closed-loop campaign; final deck, guide, proposal
    - Corner audit: PDK sf/fs shift each device further than ss/ff, so they fall outside the ss-ff
    envelope at the 0.9 V bias; textbook 3x3 NMOS x PMOS set built from the PDK's own models
    (reproduces ss/tt/ff exactly), all ordering checks pass; ngspice 47 reproduces ngspice 42
    - Compensation re-fitted on the measured f(T,V) surface (Review-2 coefficients were limited by the
    K_VCO error): tt span 8.51 -> 0.20 %, 8 of 11 corners meet +/-0.3 % (nominal)
    - Monte Carlo n=72 with corrected coefficients: 2nd order not significantly better than 1st
    (0.49 MHz, CI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
    [device_corners.csv, factorial.csv, summary.csv]
